shodanx/Micron-GLIN-v.2/docs/Рассчет тепловыделения.xlsx

Sheet: Лист1
Micron-GLIN | IC/Power bus power consumption (mA) | Vectron C4550A1-0213 | XC9572XL | LM399AH | 6xOPA189 | DAC11001A | WEG010016A | 2xLTC2057HV | LM3x7 | AD9832 | LTC6752HS5 | 2xSN74LV1T34 | ADUM4160 | STM32L152CBU6 | Total per line (mA) | Effective IC consumption (W) | Unreg. voltage (VDC) CoilV3 | Storage cap (uF) | Storage cap ripple (V) | LDO powerline noise (uV) | LDO voltage drop (V) | Dissipation on LDO (W)
 | 3.3V |  | 50.0 |  |  | 0.1 |  |  |  | 15 | 4.5 | 3 | 6 | 11.2 | 269.8 | 1.35 | 9.9 | 6800 | 0.79 | 79.35 | 4.54 | 1.331
 | +5V | 148 |  |  |  | 2 | 30
 | -15V |  |  | 36 | 7.8 | 12 |  |  | 11.4 |  |  |  |  |  | 67.2 | 1.01 | 26.3 | 2200 | 0.61 | 61.09 | 11.01 | 0.761
 | +15V |  |  | 37.3 | 7.8 | 12 |  |  | 11.4 |  |  |  |  |  | 68.5 | 1.03 | 26.3 | 2200 | 0.62 | 62.27 | 11.01 | 0.775
 | +30V |  |  |  |  |  |  | 1.8 | 4.2 |  |  |  |  |  | 5.96 | 0.18 | 42.5 | 470 | 0.25 | 25.36 | 12.35 | 0.074
 | -30V |  |  |  |  |  |  | 1.8 | 4.2 |  |  |  |  |  | 5.96 | 0.18 | 42.5 | 470 | 0.25 | 25.36 | 12.35 | 0.074
 | Effective IC consumption: |  |  |  |  | 3.742 | W
 | Dissipation on LDO: |  |  |  |  | 3.016 | W
 | Transformer Iq: |  |  |  |  | 3 | mA
 | Quiescent transformer dissipation: |  |  |  |  | 0.690 | W
 | Total: |  |  |  |  | 7.448 | W

Sheet: Рассчет трансформатора
ОСМ Т 230/Э/60-30/40-20/7-0.025-50 | Напряжение обмотки | Ток обмотки | Мощьность VA | Напряжение после выпрямления | Напряжение под типовой нагрузкой | Напряжение рассчетное при 253В
 | 30 | 0.05 | 1.5 | 41.1 | 42.48 | 46.728
 | -30 | 0.05 | 1.5 | -41.1 | -42.48 | -46.728
 | 20 | 0.25 | 5 | 27 | 26.32 | 28.952
 | -20 | 0.25 | 5 | -27 | -26.32 | -28.952
 | 7 | 1.7 | 11.9 | 9.27 | 9.933 | 10.9263
 |  |  | 24.9
ОСМ Т 230/Э/50-25/30-15/5-0.025-50 | Напряжение обмотки | Ток обмотки | Мощьность VA | Напряжение после выпрямления | Напряжение под типовой нагрузкой | Коэфицент
 | 25 | 0.1 | 2.5 | 34.05 | 35.4 | 1.416
 | -25 | 0.1 | 2.5 | -34.05 | -35.4 | 1.416
 | 15 | 0.25 | 3.75 | 19.95 | 19.74 | 1.316
 | -15 | 0.25 | 3.75 | -19.95 | -19.74 | 1.316
 | 5 | 2.5 | 12.5 | 6.45 | 7.095 | 1.419
 |  |  | 25

Sheet: ldo resistors
Vo | 15.00636364 | V | Vo | -15.04236364 | V
Iadj | 5e-05 | A | Iadj | 6.5e-05 | A
Vref | 1.25 | V | Vref | 1.25 | V
R1 | 220 | R | R1 | 220 | R | 0.007 | W
R2 | 2400 | R | R2 | 2400 | R | 0.079 | W
Vo | 29.92333333 | V | Vo | -30.02533333 | V
Iadj | 5e-05 | A | Iadj | 6.5e-05 | A
Vref | 1.25 | V | Vref | 1.25 | V
R1 | 300 | R | R1 | 300 | R | 0.005 | W
R2 | 6800 | R | R2 | 6800 | R | 0.122 | W
Vo | 7.555 | V | Vo | -7.5715 | V
Iadj | 5e-05 | A | Iadj | 6.5e-05 | A
Vref | 1.25 | V | Vref | 1.25 | V
R1 | 220 | R | R1 | 220 | R | 0.007 | W
R2 | 1100 | R | R2 | 1100 | R | 0.036 | W
