shodanx/Micron-GLIN-v.2/Timebase_CPLD_software/Timebase_CPLD/sch_pad.csv

Release 8.1i - Fit P.20131013
Copyright(c) 1995-2003 Xilinx Inc. All rights reserved
6-12-2022 9:06AM
NOTE: This file is designed to be imported into a spreadsheet program
such as Microsoft Excel for viewing | printing and sorting. The comma ' | '
character is used as the data field separator.
This file is also designed to support parsing.
Input file: sch.ngd
output file: sch_pad.csv
Part type: xc9572xl
Speed grade: -10
Package: vq44
Pinout by Pin Number:
----- | ----- | ----- | ----- | ----- | ----- | ----- | ----- | ----- | -----
Pin Number | Signal Name | Pin Usage | Pin Name | Direction | IO Standard | IO Bank Number | {blank} | Slew Rate | Termination | {blank} | Voltage | Constraint
P1 | DDS_FREQ | GCK | I/O/GCK3
P2 | TIE |  | I/O
P3 | TIE |  | I/O
P4 | GND |  | GND
P5 | TIE |  | I/O
P6 | TIE |  | I/O
P7 | TIE |  | I/O
P8 | TIE |  | I/O
P9 | TDI |  | TDI
P10 | TMS |  | TMS
P11 | TCK |  | TCK
P12 | TIE |  | I/O
P13 | TIE |  | I/O
P14 | TIE |  | I/O
P15 | VCC |  | VCCINT
P16 | TIE |  | I/O
P17 | GND |  | GND
P18 | TIE |  | I/O
P19 | Freq_control<3> | I | I/O | INPUT
P20 | Freq_control<2> | I | I/O | INPUT
P21 | Freq_control<1> | I | I/O | INPUT
P22 | Freq_control<0> | I | I/O | INPUT
P23 | CPU_IRQ | O | I/O | OUTPUT
P24 | TDO |  | TDO
P25 | GND |  | GND
P26 | VCC |  | VCCIO
P27 | DAC_LDAC | O | I/O | OUTPUT
P28 | COUNT_EN | I | I/O | INPUT
P29 | TIE |  | I/O
P30 | TIE |  | I/O
P31 | TIE |  | I/O
P32 | TIE |  | I/O
P33 | TIE |  | I/O/GSR
P34 | TIE |  | I/O/GTS2
P35 | VCC |  | VCCINT
P36 | TIE |  | I/O/GTS1
P37 | TIE |  | I/O
P38 | TIE |  | I/O
P39 | TIE |  | I/O
P40 | TIE |  | I/O
P41 | TIE |  | I/O
P42 | TIE |  | I/O
P43 | IN_10MHz | GCK | I/O/GCK1
P44 | TIE |  | I/O/GCK2
To preserve the pinout above for future design iterations in
Project Navigator simply execute the (Lock Pins) process
located under the (Implement Design) process in a toolbox named
(Optional Implementation Tools) or invoke PIN2UCF from the
command line. The location constraints will be written into your
specified UCF file
