shodanx/Micron-GLIN-v.2/Active_GLONASS_GPS_antenna/Case/Сборка1.SLDASM

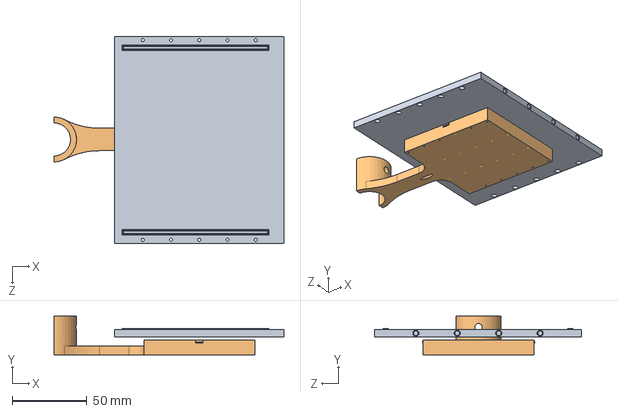
[picture p1: CAD file, 2022-07-23]
Active_GLONASS_GPS_antenna/Case/Сборка1.SLDASM
153.4 x 26.0 x 138.1 mm
buttom_part
top
