shodanx/Micron-GLIN-v.2/GLIN Case/Сборка1.SLDASM

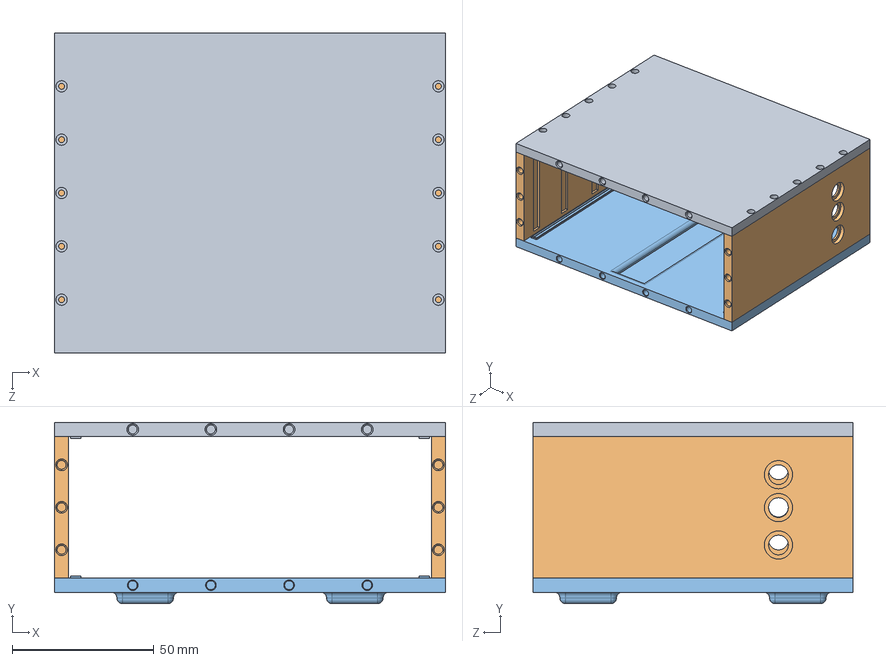
[picture p2: CAD file, 2022-07-24]
GLIN Case/Сборка1.SLDASM
138.1 x 64.0 x 113.0 mm
top
right x 2
bot
