shodanx/Micron-GLIN-v.2/SLS_parts/ADR1399_CAP/set.SLDASM

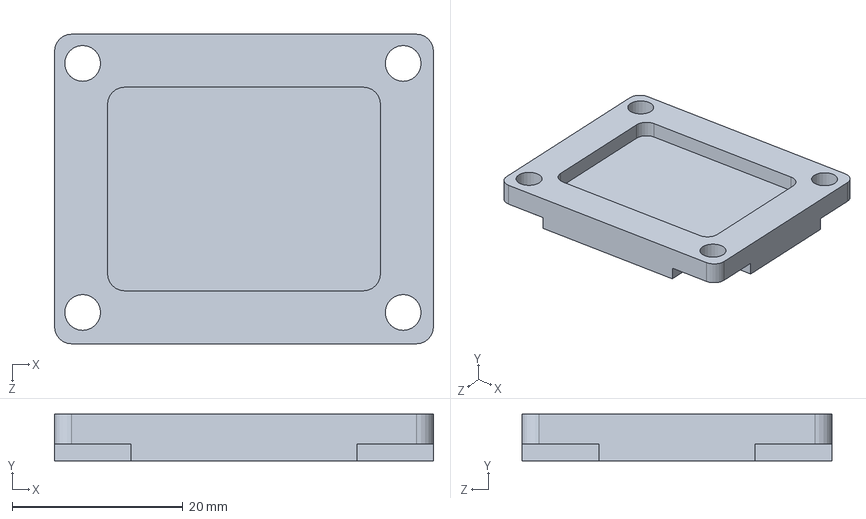
[picture p3: CAD file, 2022-04-26]
SLS_parts/ADR1399_CAP/set.SLDASM
44.5 x 5.50 x 36.3 mm
