shodanx/Micron-GLIN-v.2/SLS_parts/DAC_CAP/set.SLDASM

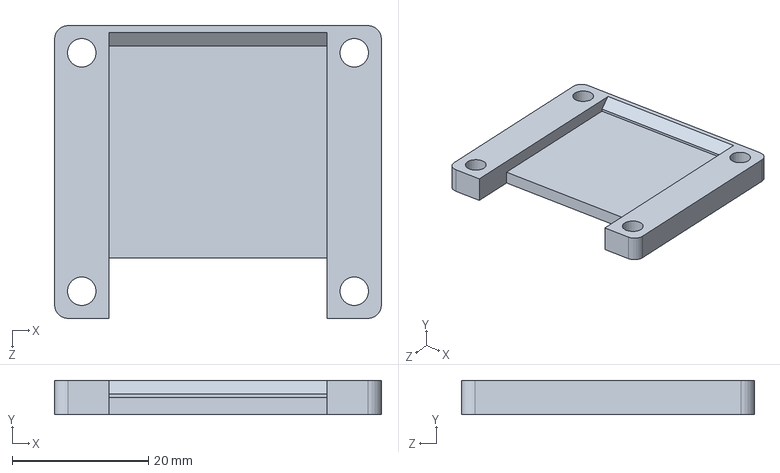
[picture p4: CAD file, 2022-04-26]
SLS_parts/DAC_CAP/set.SLDASM
48.0 x 5.00 x 43.0 mm
