shodanx/Micron-GLIN-v.2/SLS_parts/OCXO_CAP/set.SLDASM

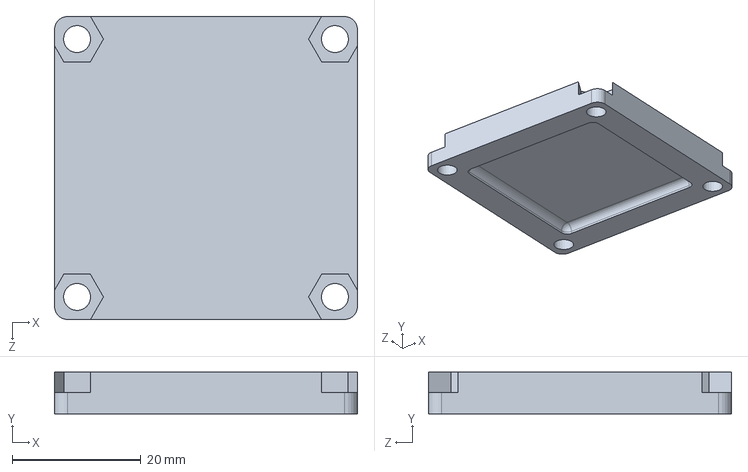
[picture p5: CAD file, 2022-04-26]
SLS_parts/OCXO_CAP/set.SLDASM
47.0 x 6.50 x 47.0 mm
