shodanx/Micron-GLIN-v.2/Active_GLONASS_GPS_antenna/Case/buttom_part.SLDPRT

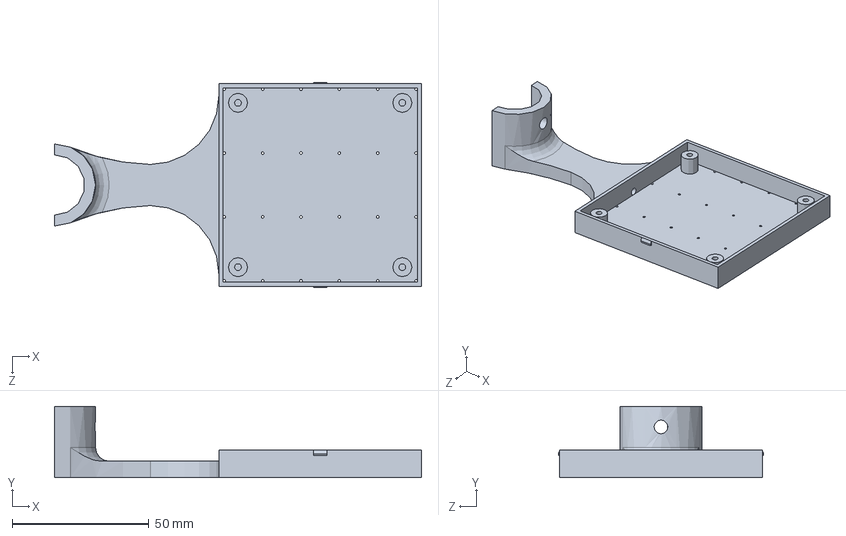
[picture p6: CAD file, 2022-07-24]
Active_GLONASS_GPS_antenna/Case/buttom_part.SLDPRT
134.0 x 26.0 x 75.0 mm
