shodanx/Micron-GLIN-v.2/GLIN Case/top.SLDPRT

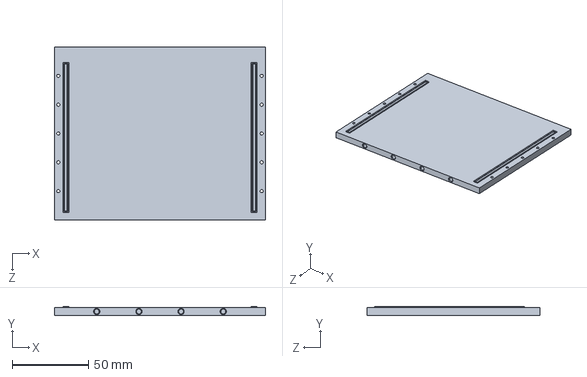
[picture p7: CAD file, 2022-07-24]
GLIN Case/top.SLDPRT
138.1 x 5.70 x 113.0 mm
