shodanx/Micron-GLIN-v.2/SLS_parts/ADR1399_CAP/ADR1399_soldering_tool.STEP

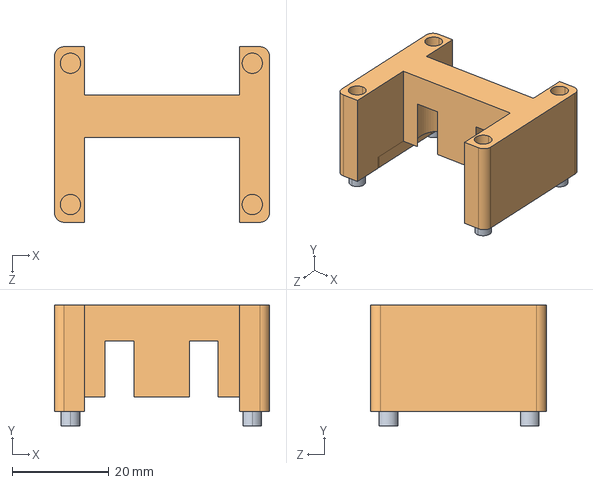
[picture p8: CAD file, 2022-04-26]
SLS_parts/ADR1399_CAP/ADR1399_soldering_tool.STEP
44.5 x 25.0 x 36.3 mm
