shodanx/Micron-GLIN-v.2/SLS_parts/LM399_CAP/LM399AH_UP.STEP

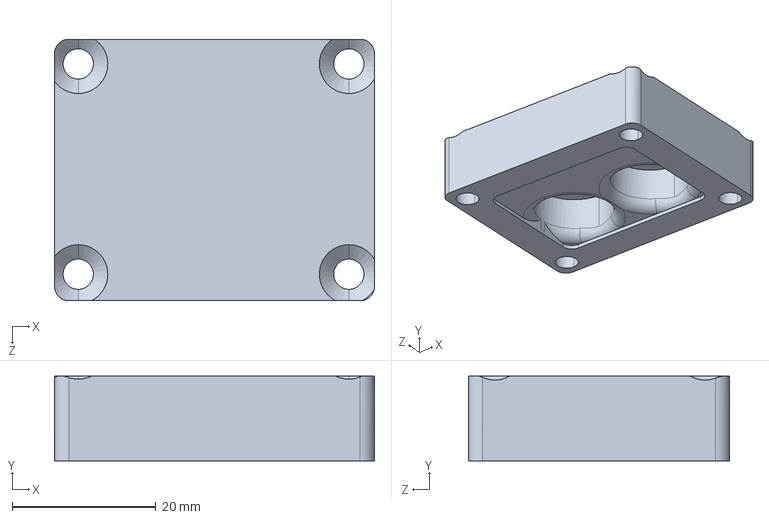
[picture p9: CAD file, 2022-04-26]
SLS_parts/LM399_CAP/LM399AH_UP.STEP
44.5 x 11.8 x 36.3 mm
