shodanx/Micron-GLIN-v.2/SLS_parts/OCXO_CAP/OCXO_up.STEP

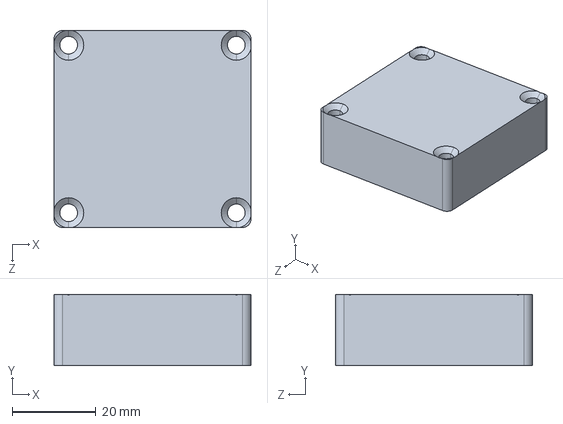
[picture p10: CAD file, 2022-04-26]
SLS_parts/OCXO_CAP/OCXO_up.STEP
47.0 x 17.0 x 47.0 mm
