shodanx/Micron-GLIN-v.2/Active_GLONASS_GPS_antenna/Case/top.SLDPRT

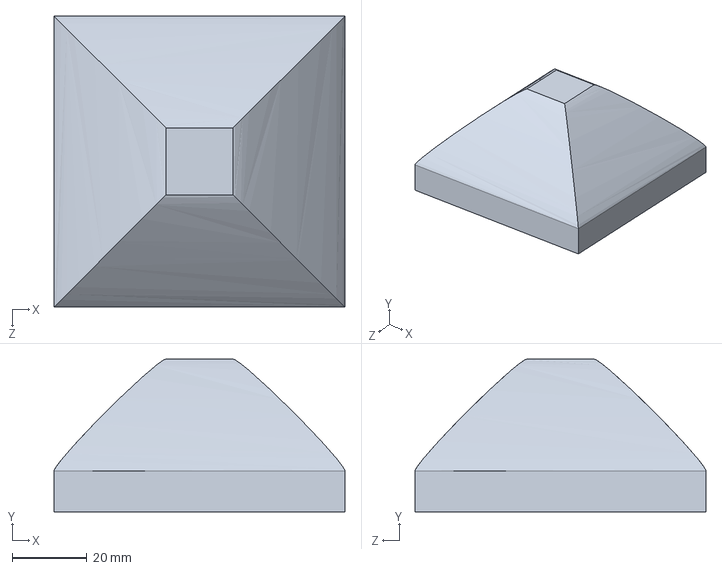
[picture p11: CAD file, 2022-07-23]
Active_GLONASS_GPS_antenna/Case/top.SLDPRT
78.0 x 41.0 x 78.0 mm
