shodanx/Micron-GLIN-v.2/GLIN Case/bot.SLDPRT

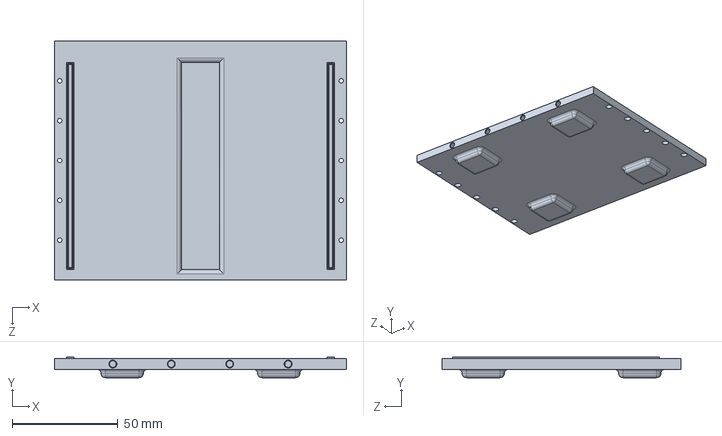
[picture p12: CAD file, 2022-07-24]
GLIN Case/bot.SLDPRT
138.1 x 9.70 x 113.0 mm
