shodanx/Micron-GLIN-v.2/GLIN Case/right.SLDPRT

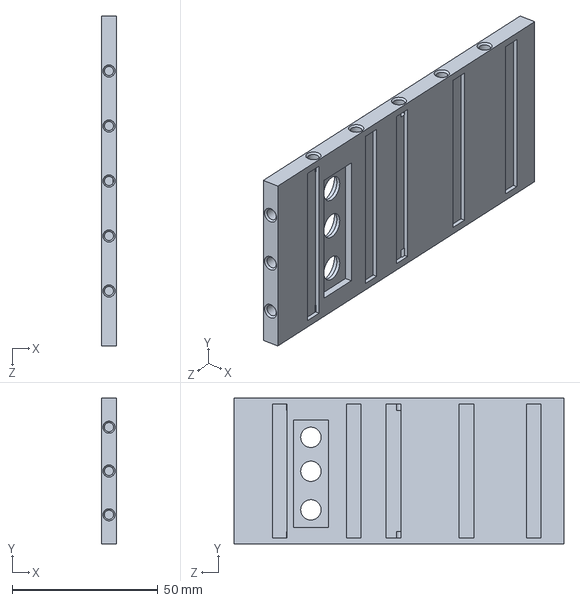
[picture p13: CAD file, 2022-07-24]
GLIN Case/right.SLDPRT
5.00 x 50.0 x 113.0 mm
