shodanx/Micron-GLIN-v.2/SLS_parts/ADR1399_CAP/ADR1399_UP.STEP

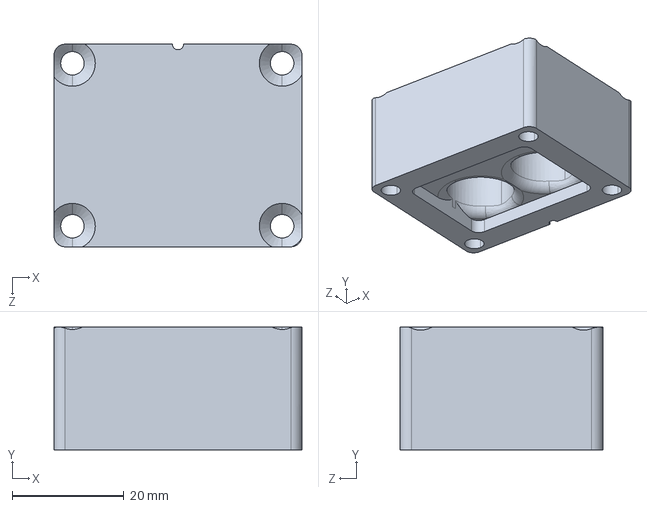
[picture p14: CAD file, 2022-04-26]
SLS_parts/ADR1399_CAP/ADR1399_UP.STEP
44.5 x 22.0 x 36.3 mm
