shodanx/Micron-GLIN-v.2/(list of files, cad)

Other CAD files:
Timebase_CPLD_software/Timebase_CPLD/isim/sch_isim_beh.exe.sim/work/sch_isim_beh.exe_main.nt64.obj
SLS_parts/DAC_CAP/DAC_down.STEP
Timebase_CPLD_software/Timebase_CPLD/isim/precompiled.exe.sim/ieee/p_1242562249.nt64.obj
Timebase_CPLD_software/Timebase_CPLD/isim/sch_isim_beh.exe.sim/unisim/a_4147737283_2967259552.nt64.obj
Timebase_CPLD_software/Timebase_CPLD/isim/sch_isim_beh.exe.sim/work/a_3463945714_3212880686.nt64.obj
SLS_parts/ADR1399_CAP/ADR1399_DOWN.STEP
SLS_parts/DAC_CAP/DAC_up.STEP
SLS_parts/OCXO_CAP/OCXO_down.STEP
Timebase_CPLD_software/Timebase_CPLD/isim/precompiled.exe.sim/ieee/p_2592010699.nt64.obj
Timebase_CPLD_software/Timebase_CPLD/isim/sch_isim_beh.exe.sim/unisim/a_2867636556_1359619727.nt64.obj
Timebase_CPLD_software/Timebase_CPLD/isim/sch_isim_beh.exe.sim/unisim/a_4207005572_0559031411.nt64.obj
Timebase_CPLD_software/Timebase_CPLD/isim/sch_isim_beh.exe.sim/work/a_2451983098_3212880686.nt64.obj
Timebase_CPLD_software/Timebase_CPLD/isim/sch_isim_beh.exe.sim/unisim/a_2211953871_3811244703.nt64.obj
Timebase_CPLD_software/Timebase_CPLD/isim/sch_isim_beh.exe.sim/work/a_2857804981_3212880686.nt64.obj
Timebase_CPLD_software/Timebase_CPLD/isim/sch_isim_beh.exe.sim/unisim/a_3056901965_2640411640.nt64.obj
Timebase_CPLD_software/Timebase_CPLD/isim/sch_isim_beh.exe.sim/work/a_2267817849_3212880686.nt64.obj
Timebase_CPLD_software/Timebase_CPLD/isim/sch_isim_beh.exe.sim/unisim/a_3055263662_1392679692.nt64.obj
Timebase_CPLD_software/Timebase_CPLD/isim/sch_isim_beh.exe.sim/work/a_3195776209_3212880686.nt64.obj
Timebase_CPLD_software/Timebase_CPLD/isim/sch_isim_beh.exe.sim/unisim/a_3828308815_1222000726.nt64.obj
Timebase_CPLD_software/Timebase_CPLD/isim/sch_isim_beh.exe.sim/work/a_3409553495_3212880686.nt64.obj
Timebase_CPLD_software/Timebase_CPLD/isim/sch_isim_beh.exe.sim/unisim/a_1801614988_1818890047.nt64.obj
Timebase_CPLD_software/Timebase_CPLD/isim/sch_isim_beh.exe.sim/work/a_0098054934_3212880686.nt64.obj
Timebase_CPLD_software/Timebase_CPLD/isim/sch_isim_beh.exe.sim/unisim/a_2077515722_3691801974.nt64.obj
Timebase_CPLD_software/Timebase_CPLD/isim/sch_isim_beh.exe.sim/work/a_0897150575_3212880686.nt64.obj
Timebase_CPLD_software/Timebase_CPLD/isim/sch_isim_beh.exe.sim/unisim/a_2211589156_2274105955.nt64.obj
Timebase_CPLD_software/Timebase_CPLD/isim/sch_isim_beh.exe.sim/work/a_1424174025_3212880686.nt64.obj
Timebase_CPLD_software/Timebase_CPLD/isim/sch_isim_beh.exe.sim/unisim/a_1391413833_1848422758.nt64.obj
Timebase_CPLD_software/Timebase_CPLD/isim/sch_isim_beh.exe.sim/work/a_4223124715_3212880686.nt64.obj
Timebase_CPLD_software/Timebase_CPLD/isim/sch_isim_beh.exe.sim/unisim/a_3762448000_2971575191.nt64.obj
Timebase_CPLD_software/Timebase_CPLD/isim/sch_isim_beh.exe.sim/work/a_2808649626_3212880686.nt64.obj
Timebase_CPLD_software/Timebase_CPLD/isim/sch_isim_beh.exe.sim/unisim/a_3988446151_0546328132.nt64.obj
Timebase_CPLD_software/Timebase_CPLD/isim/sch_isim_beh.exe.sim/work/a_0418817255_3212880686.nt64.obj
Timebase_CPLD_software/Timebase_CPLD/isim/sch_isim_beh.exe.sim/unisim/a_2233457742_0889792898.nt64.obj
Timebase_CPLD_software/Timebase_CPLD/isim/sch_isim_beh.exe.sim/work/a_1497938270_3212880686.nt64.obj
Timebase_CPLD_software/Timebase_CPLD/isim/sch_isim_beh.exe.sim/unisim/a_2562466605_1496654361.nt64.obj
Timebase_CPLD_software/Timebase_CPLD/isim/sch_isim_beh.exe.sim/unisim/p_0947159679.nt64.obj
Timebase_CPLD_software/Timebase_CPLD/isim/sch_isim_beh.exe.sim/unisim/a_2661327437_0605893366.nt64.obj
Timebase_CPLD_software/Timebase_CPLD/isim/sch_isim_beh.exe.sim/unisim/a_1823427465_3721267009.nt64.obj
Timebase_CPLD_software/Timebase_CPLD/isim/sch_isim_beh.exe.sim/unisim/a_1947232985_2580864354.nt64.obj
Timebase_CPLD_software/Timebase_CPLD/isim/sch_isim_beh.exe.sim/unisim/a_1113154319_3729445679.nt64.obj
Timebase_CPLD_software/Timebase_CPLD/isim/sch_isim_beh.exe.sim/unisim/a_1490675510_1976025627.nt64.obj
Timebase_CPLD_software/Timebase_CPLD/isim/sch_isim_beh.exe.sim/unisim/a_1717296735_4086321779.nt64.obj
Timebase_CPLD_software/Timebase_CPLD/isim/sch_isim_beh.exe.sim/unisim/a_0147727936_3632337348.nt64.obj
Timebase_CPLD_software/Timebase_CPLD/isim/sch_isim_beh.exe.sim/unisim/a_2472646025_1397528790.nt64.obj
Timebase_CPLD_software/Timebase_CPLD/isim/sch_isim_beh.exe.sim/unisim/a_2312877582_0635394241.nt64.obj
Timebase_CPLD_software/Timebase_CPLD/isim/sch_isim_beh.exe.sim/unisim/a_2904659017_3769511665.nt64.obj
SLS_parts/ADR1399_CAP/ADR1399_DOWN.SLDPRT
SLS_parts/ADR1399_CAP/ADR1399_UP.SLDPRT
SLS_parts/ADR1399_CAP/ADR1399_soldering_tool.SLDPRT
SLS_parts/DAC_CAP/DAC_down.SLDPRT
SLS_parts/DAC_CAP/DAC_up.SLDPRT
SLS_parts/LM399_CAP/LM399AH_UP.SLDPRT
SLS_parts/OCXO_CAP/OCXO_down.SLDPRT
SLS_parts/OCXO_CAP/OCXO_up.SLDPRT
