shodanx/Micron-GLIN-v.2/docs/INL_fix.xlsx

Sheet: Data
Poly_temp_A | -8.4559e-22 | Step 2 - calculate and place poly. coefficents
Poly_temp_B | 1.7961e-15
Poly_temp_C | -9.7371e-10
Poly_temp_D | 0.00013705
 | Step 1 - place data here
Time (s) | Reading (V) | DAC Code | diff 2 step (mV/s) | diff 10 step(mV/s) | Ideal | Error INL | Error calc | Error speed | Correction_coeff | St_dev | Avg | RSD
1 | -9.97158607 | 524.8128128 |  |  |  |  |  |  |  | 0.0002592288754 | 10.000009 | 2.592286368e-05 | 10.0005 | 1.00005 | 10.000000000
2 | -9.96158394 | 1049.625626 | 10.002130 |  | -9.961443 | 0.000141 | 0.000136
3 | -9.95157888 | 1574.438438 | 10.005060 |  | -9.951443 | 0.000136 | 0.000136 | -0.0000005 | 1.0000509 | Step |  | DAC code per step
4 | -9.94157767 | 2099.251251 | 10.001210 | 10.001221 | -9.941443 | 0.000135 | 0.000135 | -0.0000005 | 1.0000508 | 0.01 |  | 524.8128128
5 | -9.93157697 | 2624.064064 | 10.000700 | 10.000838 | -9.931443 | 0.000134 | 0.000135 | -0.0000005 | 1.0000507
6 | -9.92157523 | 3148.876877 | 10.001740 | 10.000759 | -9.921443 | 0.000132 | 0.000134 | -0.0000005 | 1.0000506
7 | -9.91157488 | 3673.68969 | 10.000350 | 10.000514 | -9.911443 | 0.000132 | 0.000133 | -0.0000005 | 1.0000505
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
