shodanx/Micron-GLIN-v.2/Project_Files/Schematic/Active_GNSS_antenna.PDF

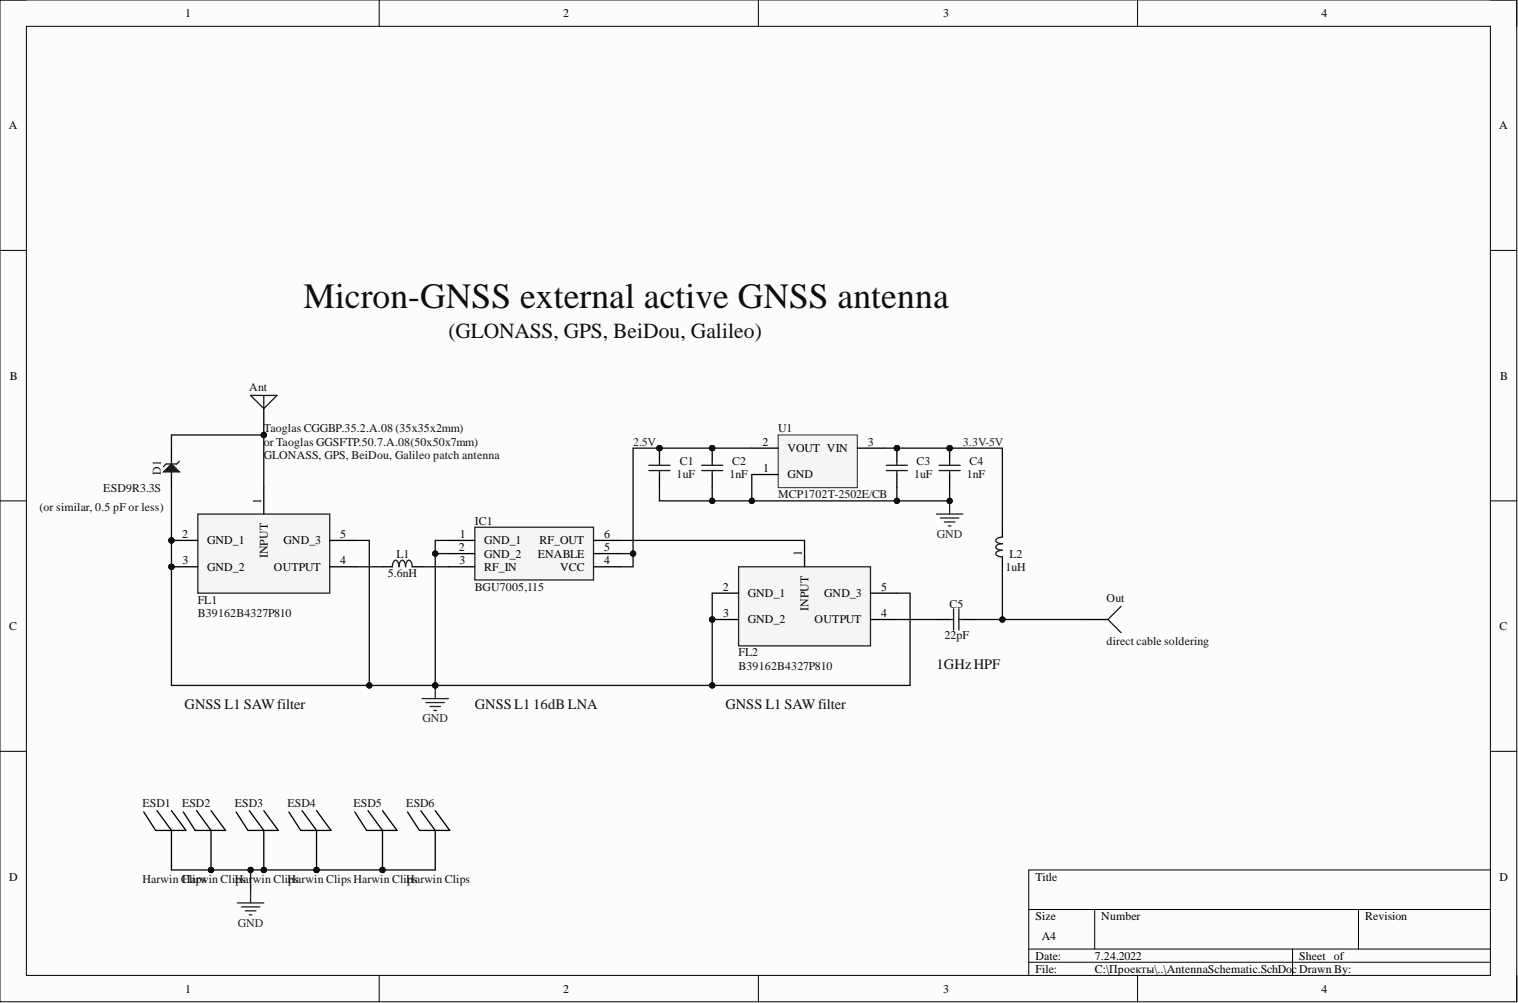
[picture p15: page 1]

Micron-GNSS external active GNSS antenna

(GLONASS, GPS, BeiDou, Galileo)

Taoglas CGGBP.35.2.A.08 (35x35x2mm)
or Taoglas GGSFTP.50.7.A.08(50x50x7mm)
GLONASS, GPS, BeiDou, Galileo patch antenna

(or similar, 0.5 pF or less)
