shodanx/Micron-GLIN-v.2/Project_Files/Schematic/Timebase board.PDF

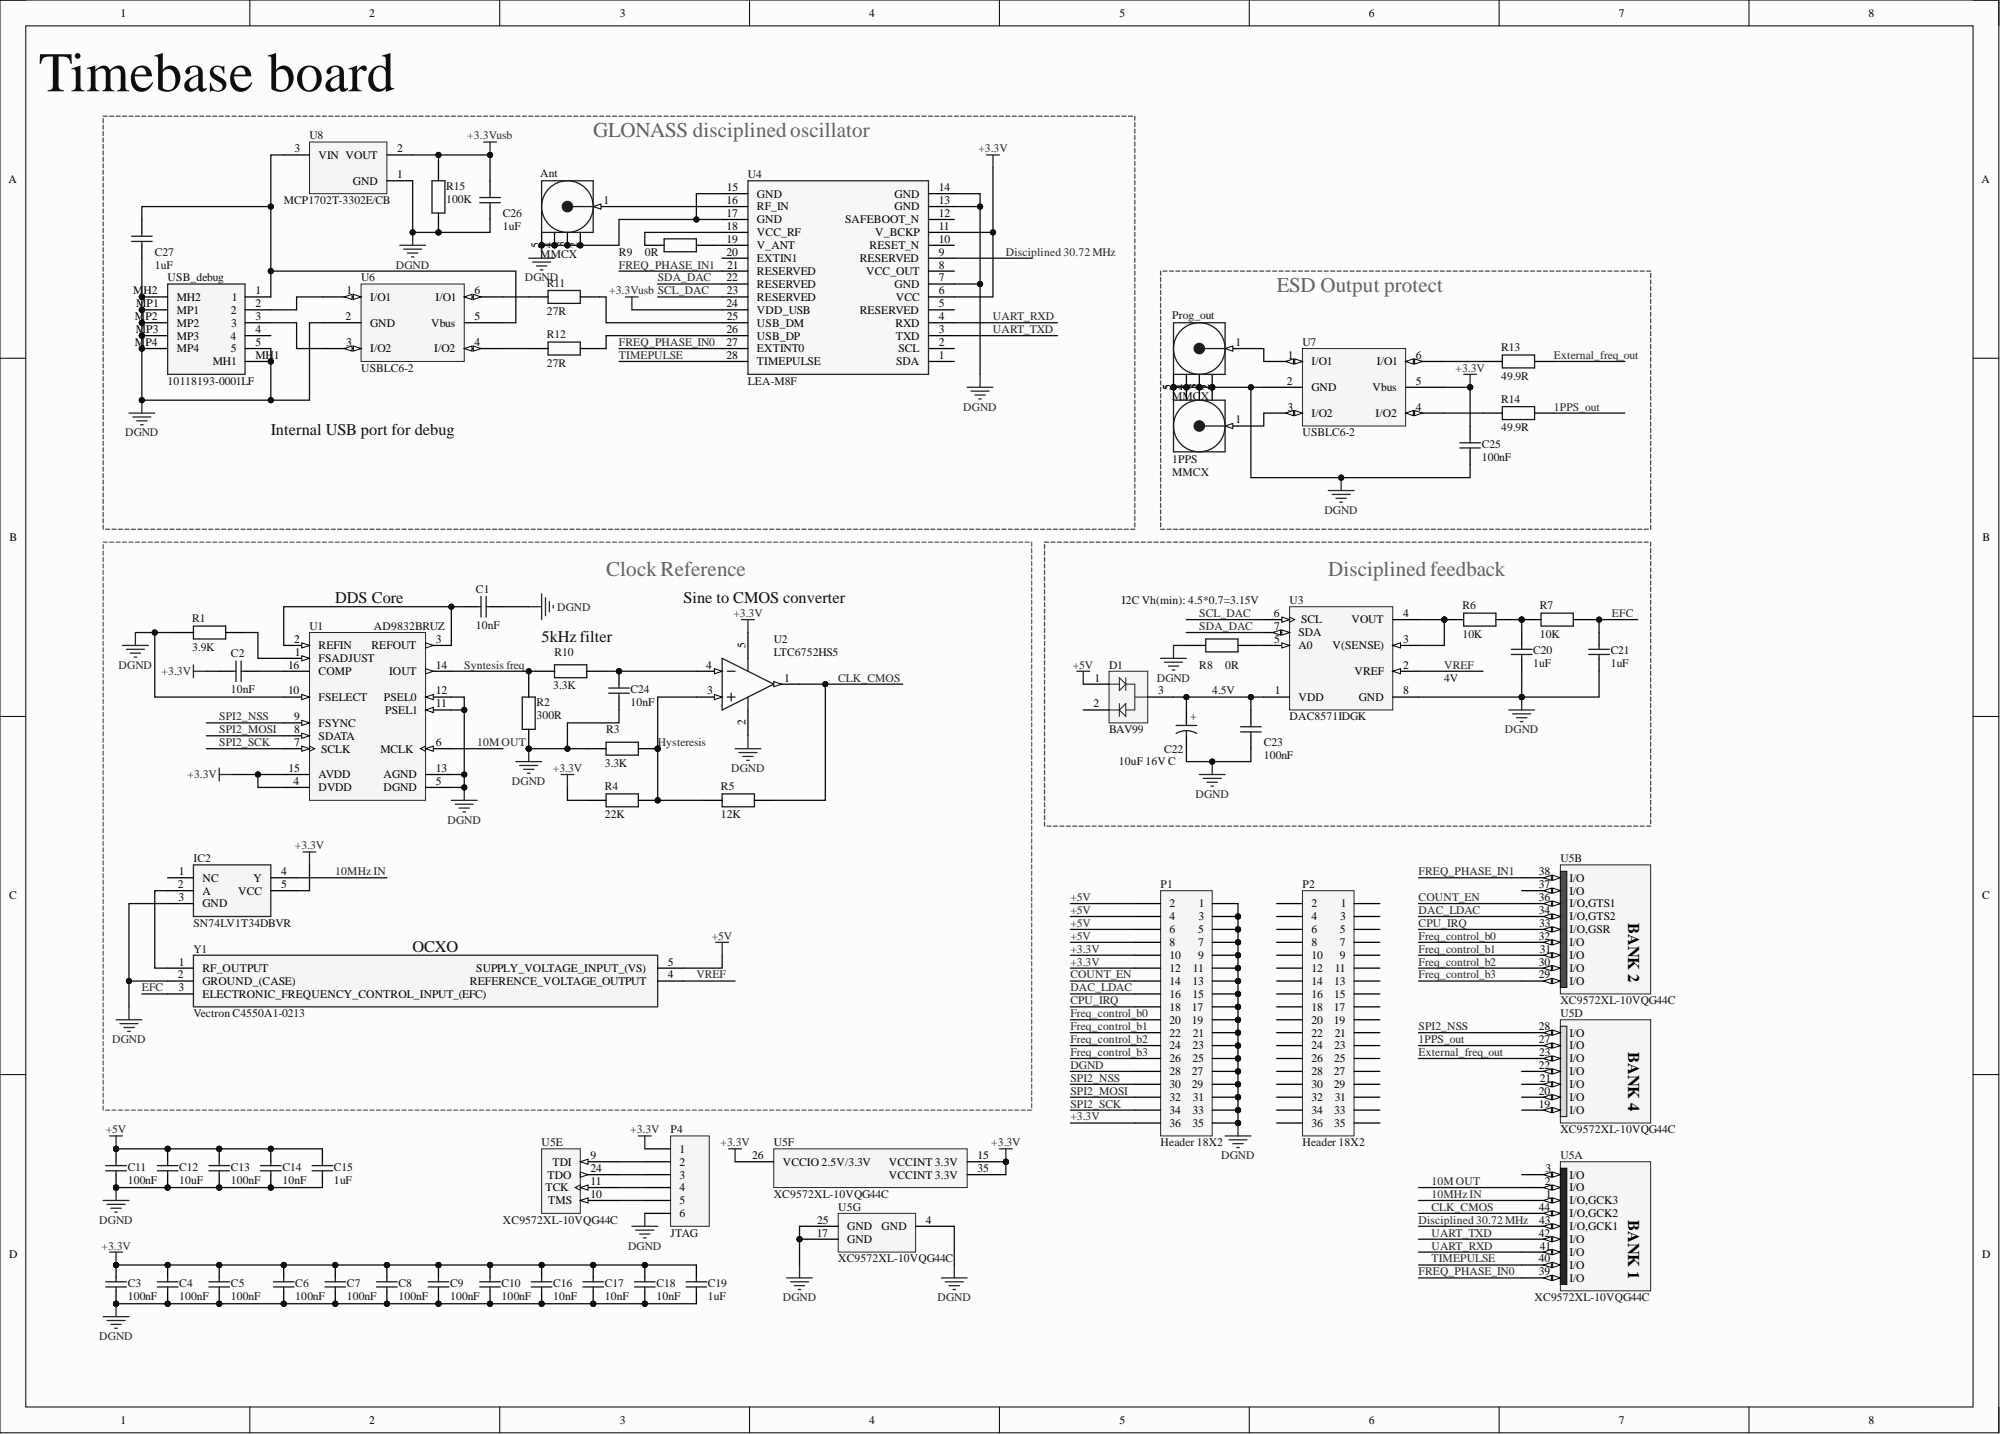
[picture p16: page 1]

RF_IN 16 GND 17

VCC_RF 18

Internal USB port for debug
