shodanx/Micron-GLIN-v.2/Project_Files/Schematic/DAC board.PDF

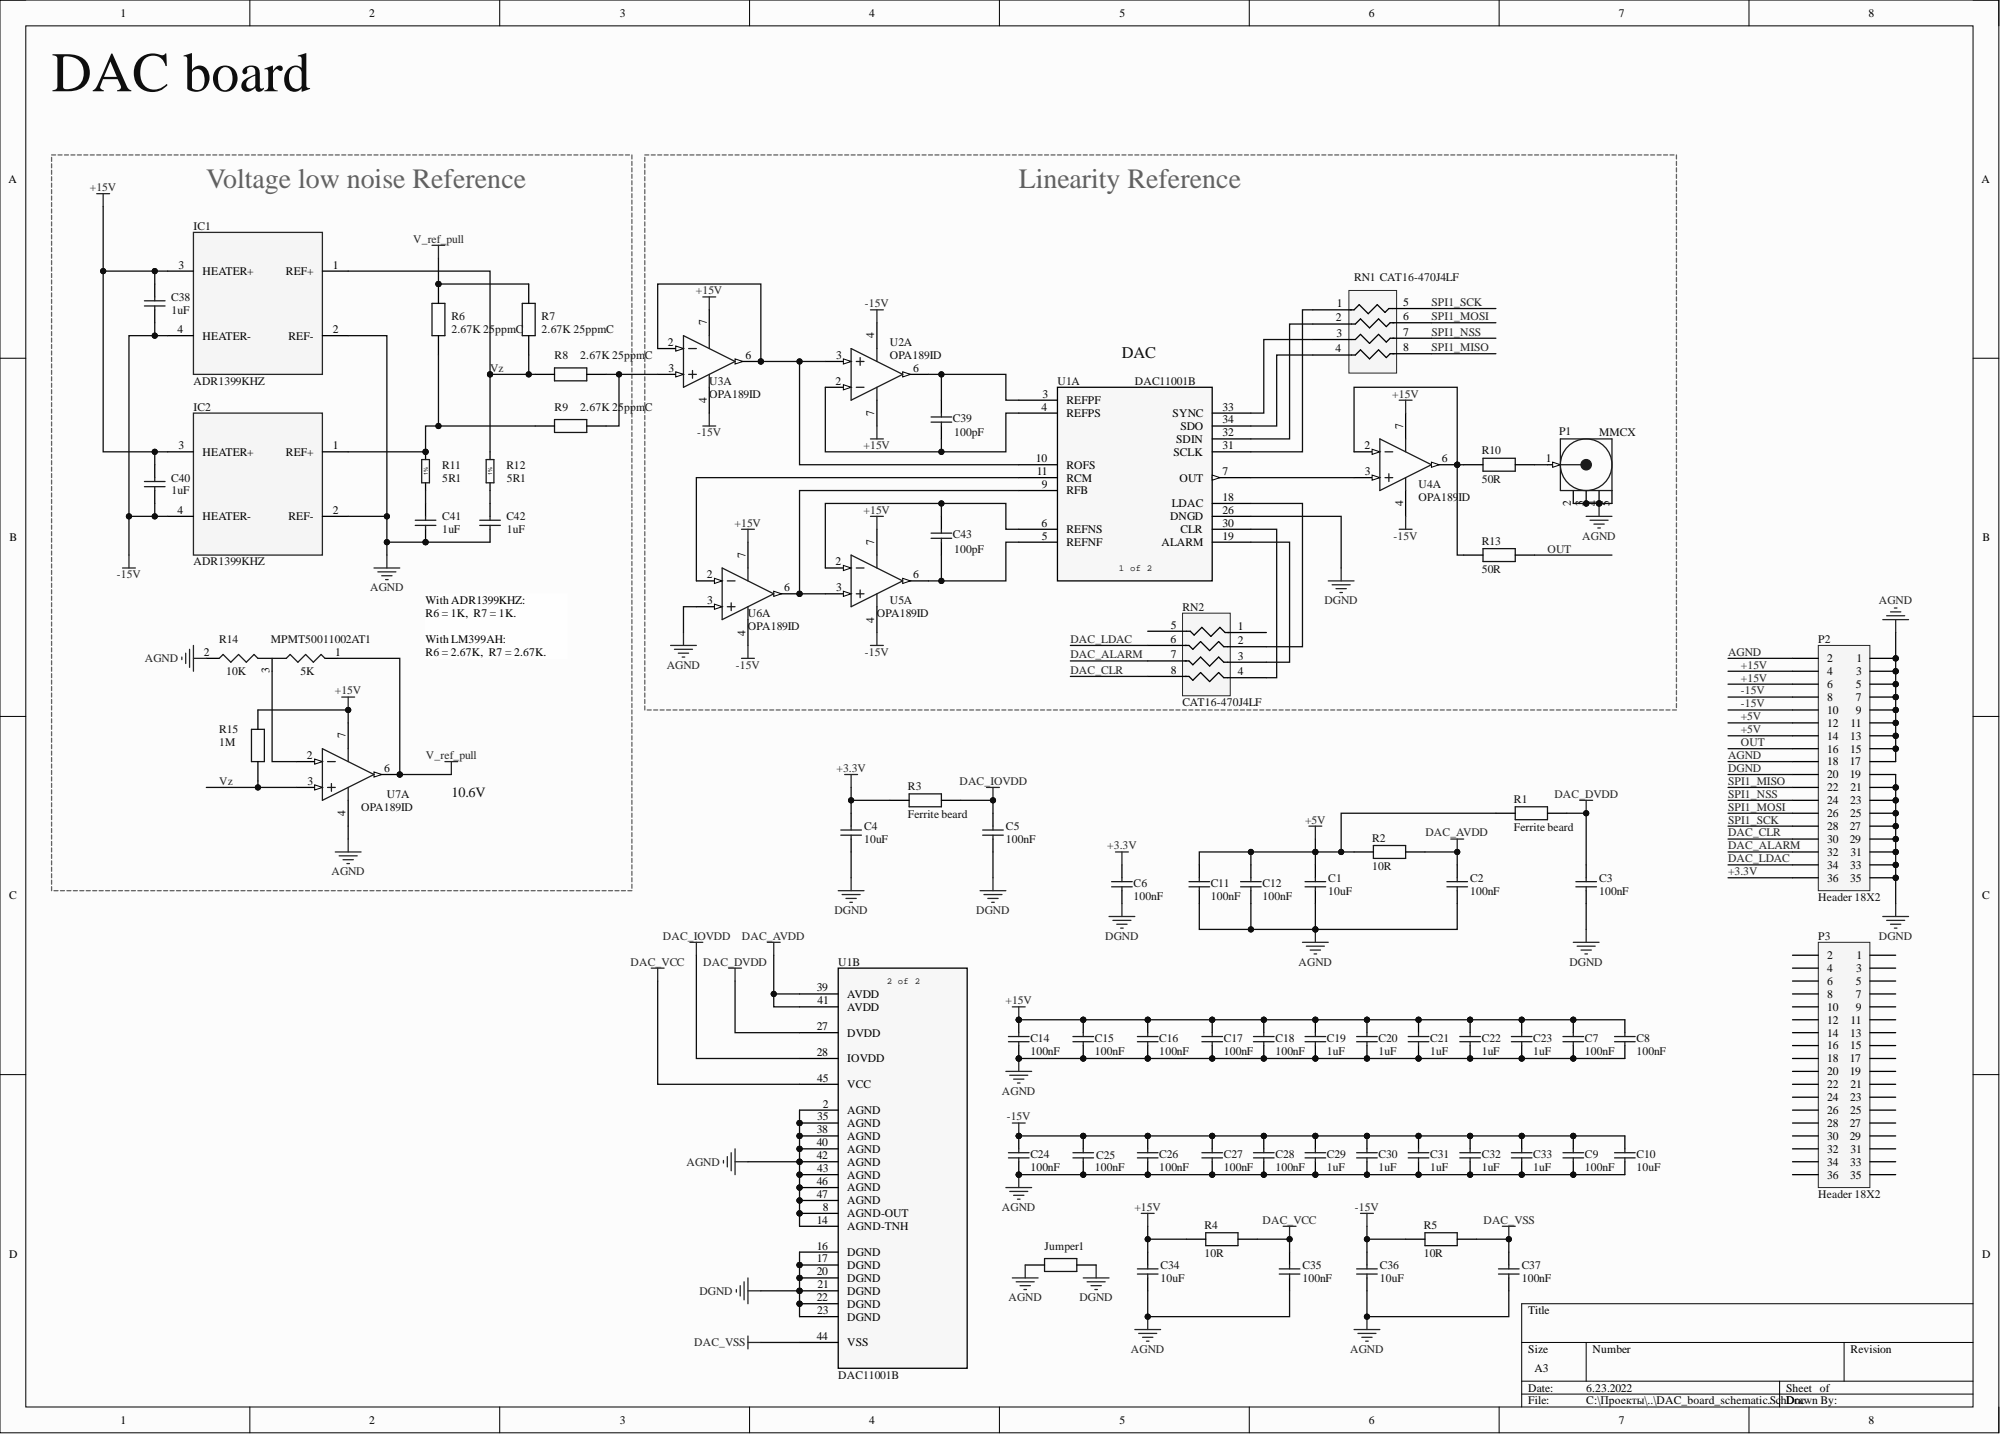
[picture p17: page 1]

Voltage low noise Reference

C38 1uF | HEATER- 4

REFPS 4

RCM 11 | 3
RFB 9

REFNF 5 REFNS 6

C43
100pF
