shodanx/Micron-GLIN-v.2/Project_Files/Schematic/Output board.PDF

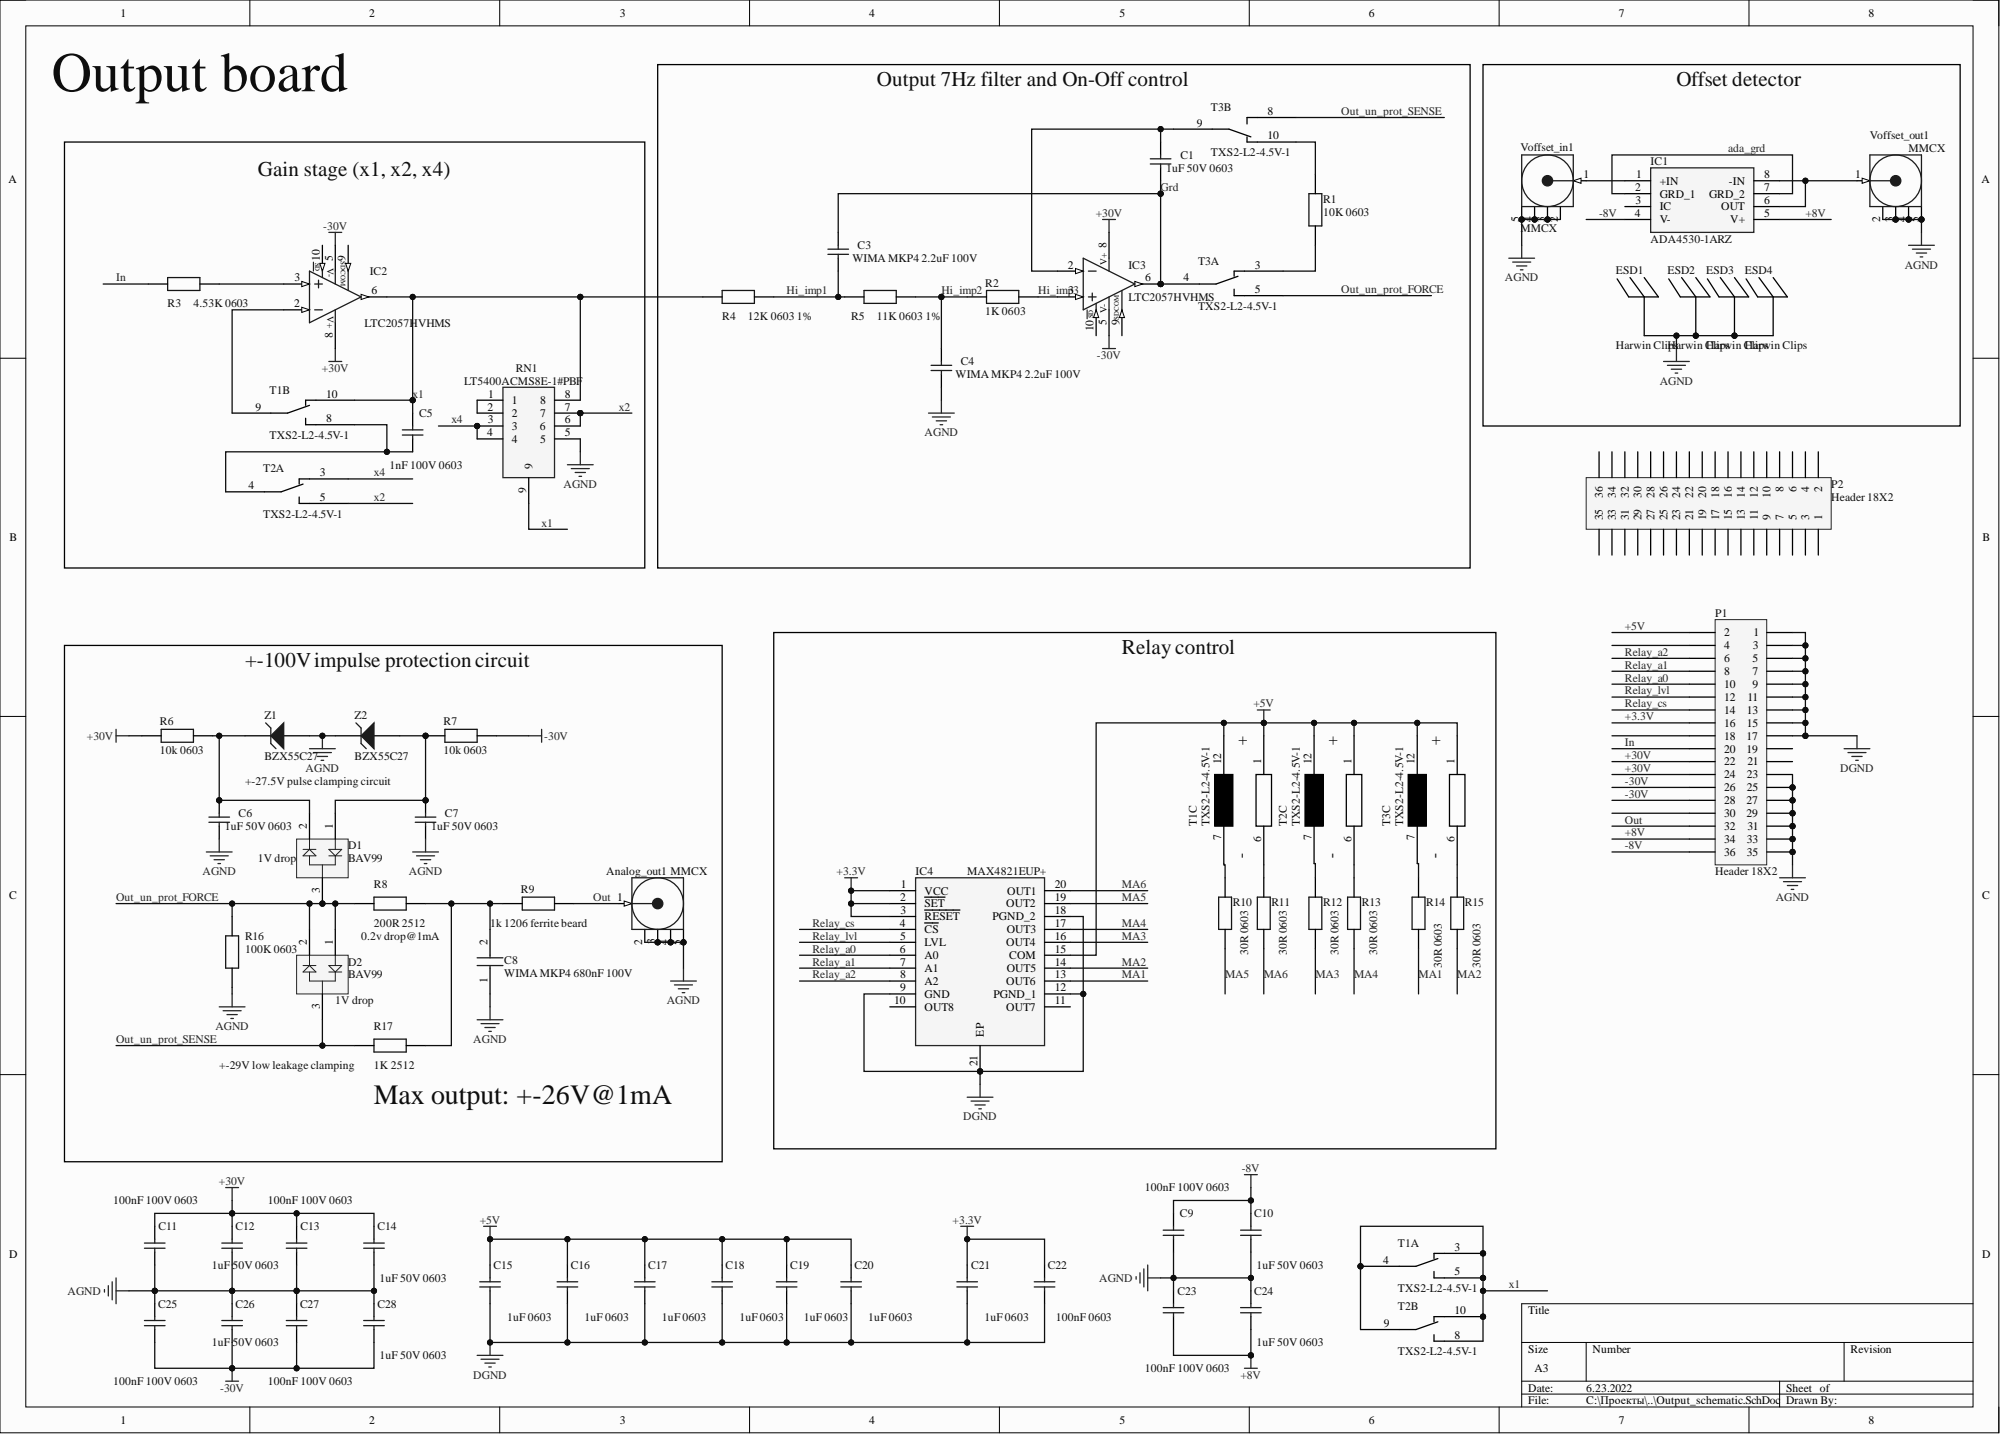
[picture p18: page 1]

Output 7Hz filter and On-Off control
