shodanx/Micron-GLIN-v.2/Project_Files/Schematic/Digital board.PDF

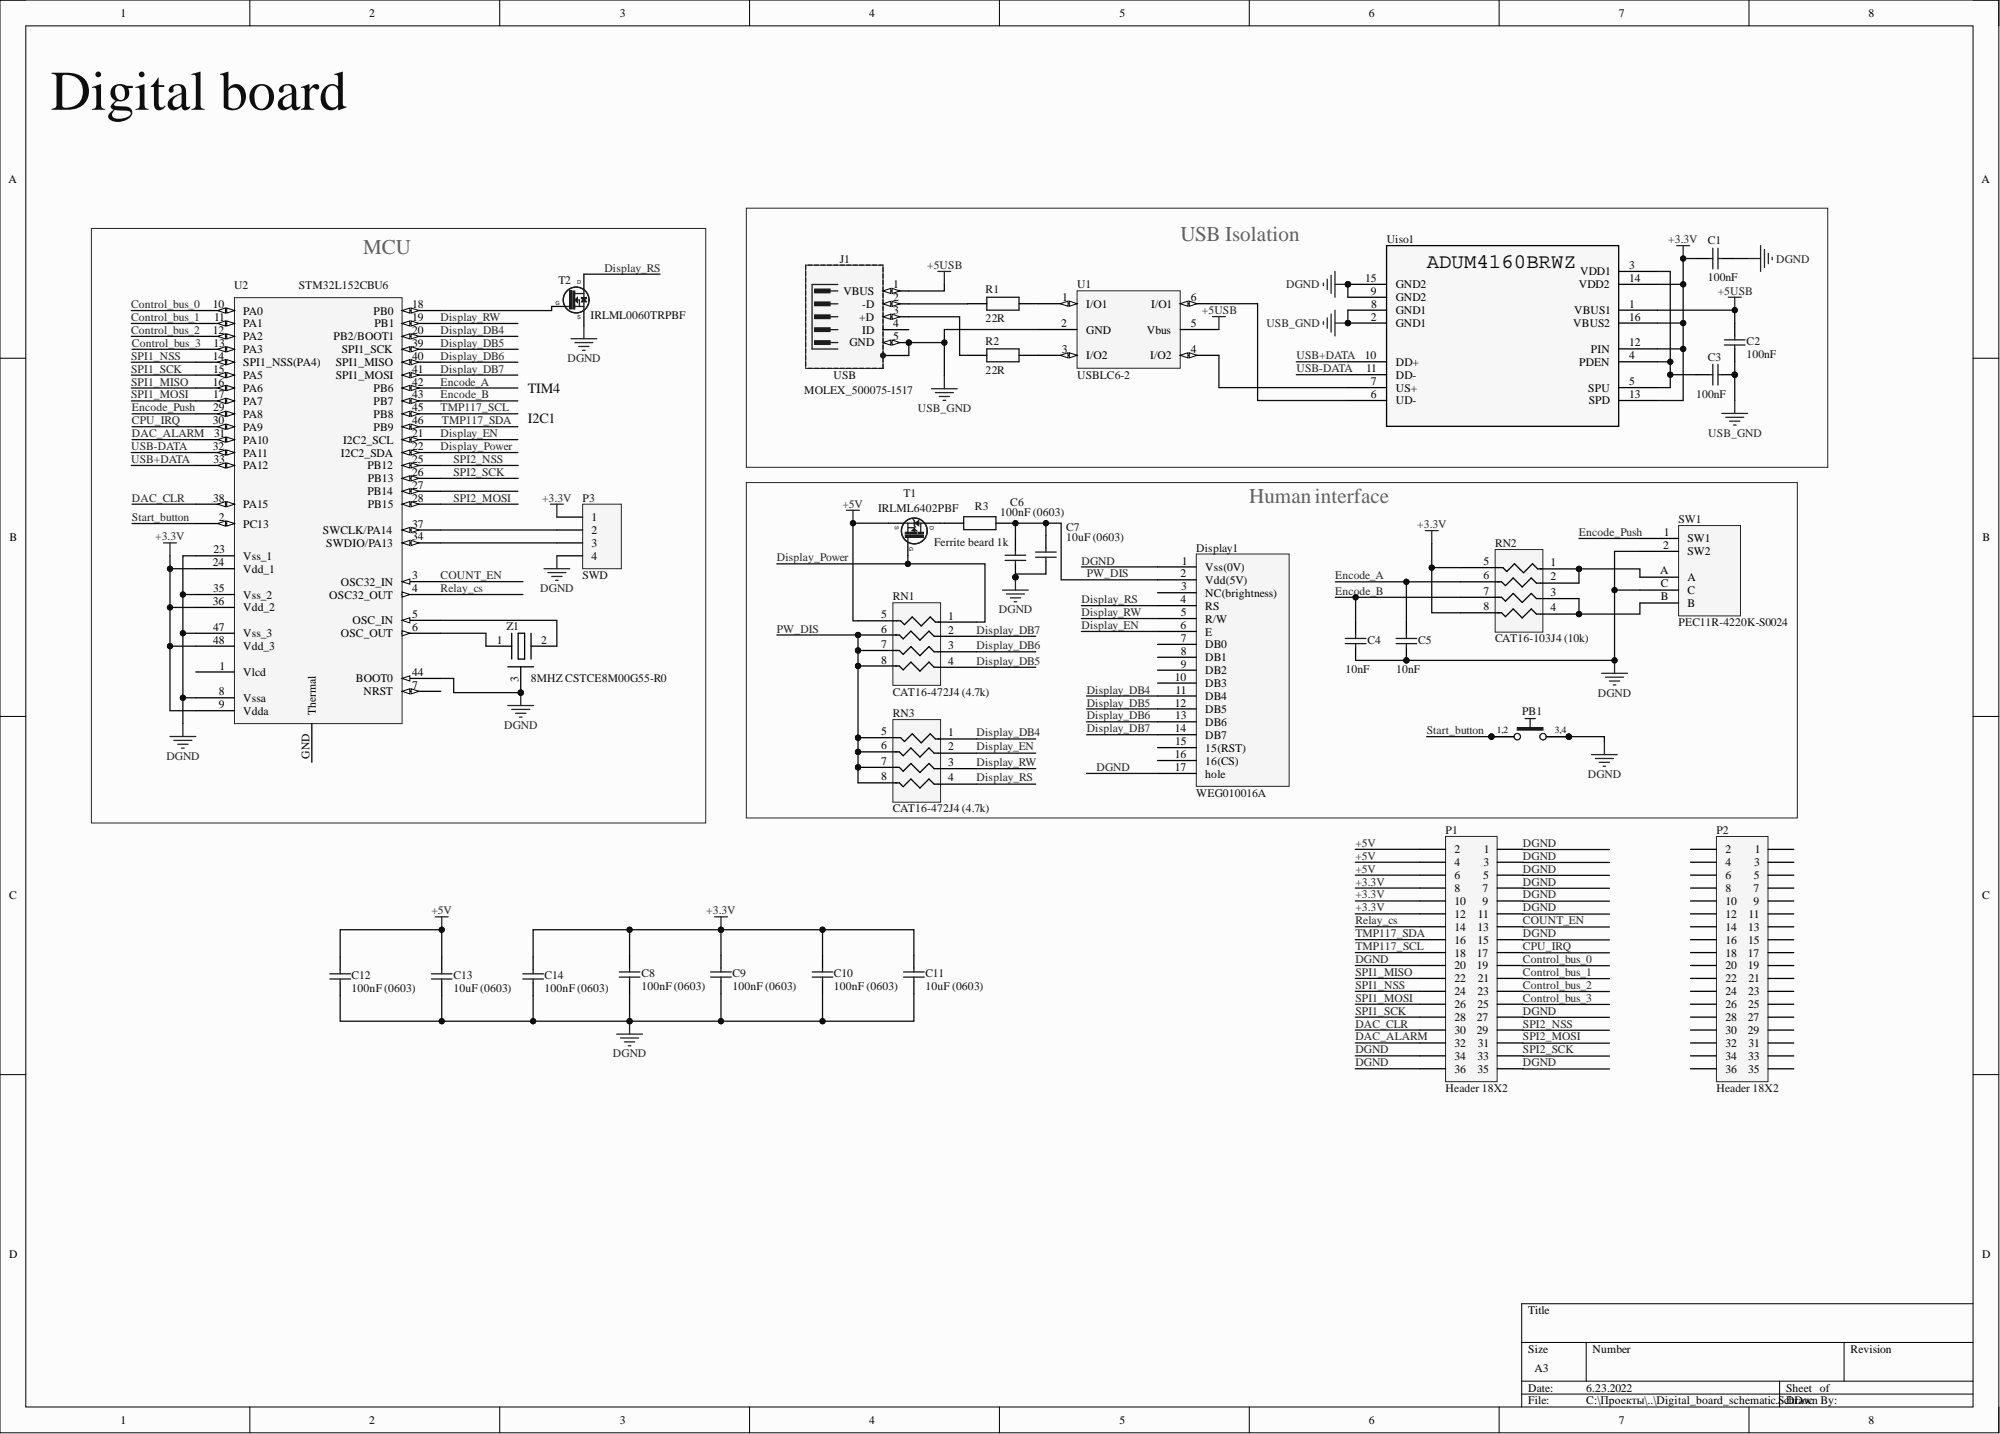
[picture p19: page 1]
