shodanx/Micron-GLIN-v.2/Project_Files/Schematic/External_Power_supply.PDF

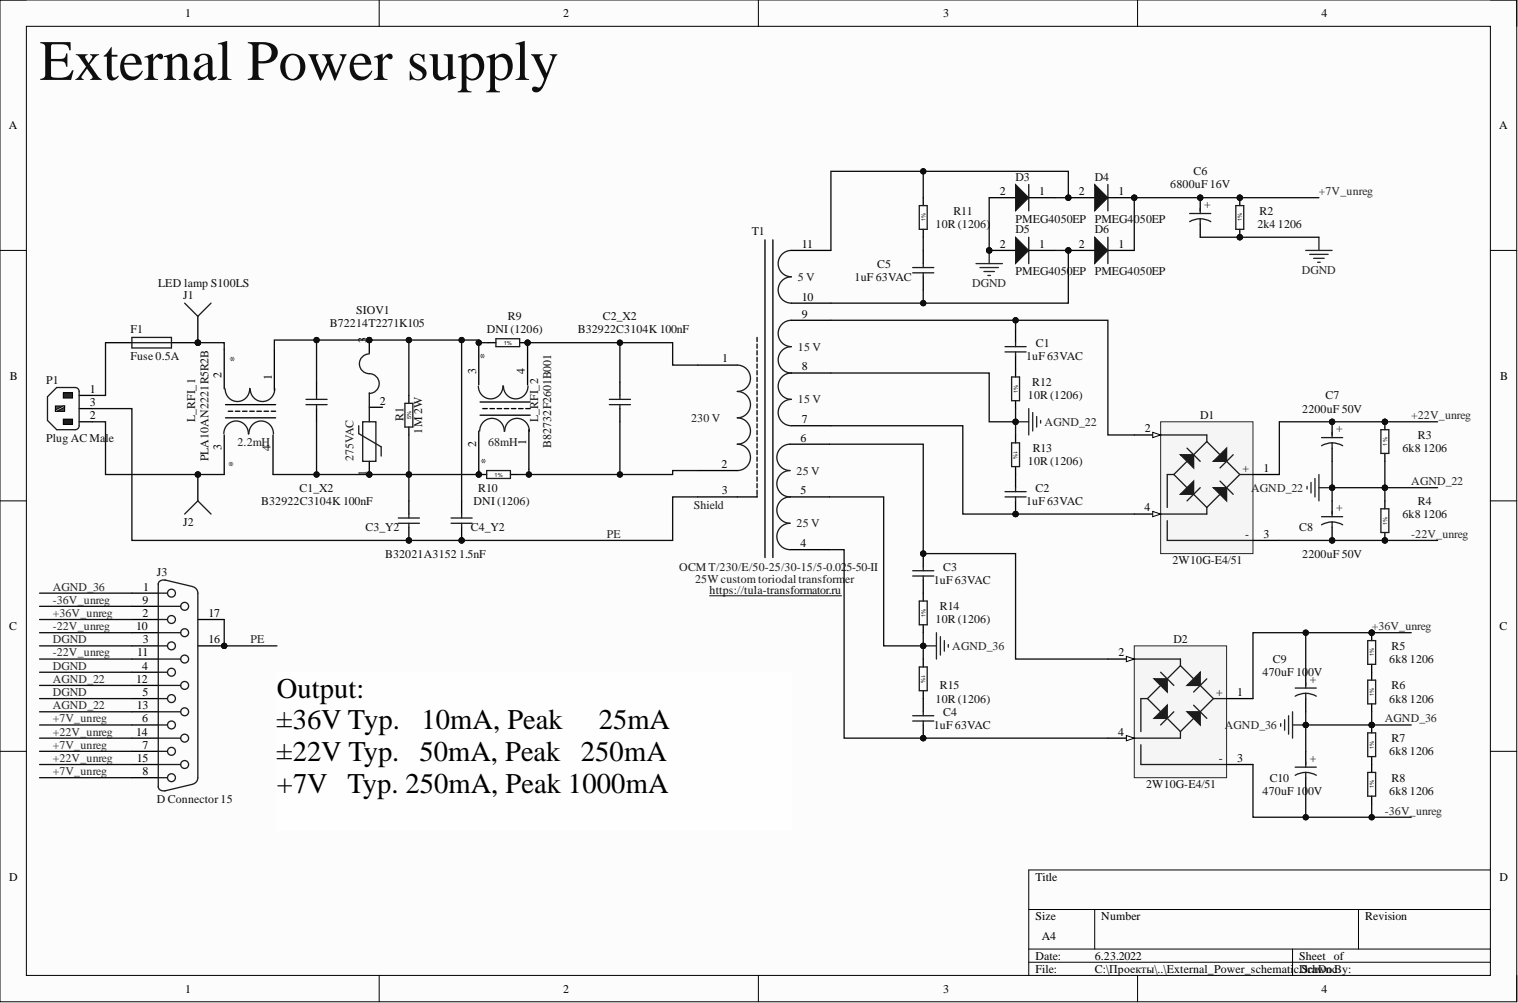
[picture p20: page 1]

OCM T/230/E/50-25/30-15/5-0.025-50-II
25W custom toriodal transformer
https://tula-transformator.ru
