shodanx/Micron-GLIN-v.2/Project_Files/Schematic/Internal Power board.PDF

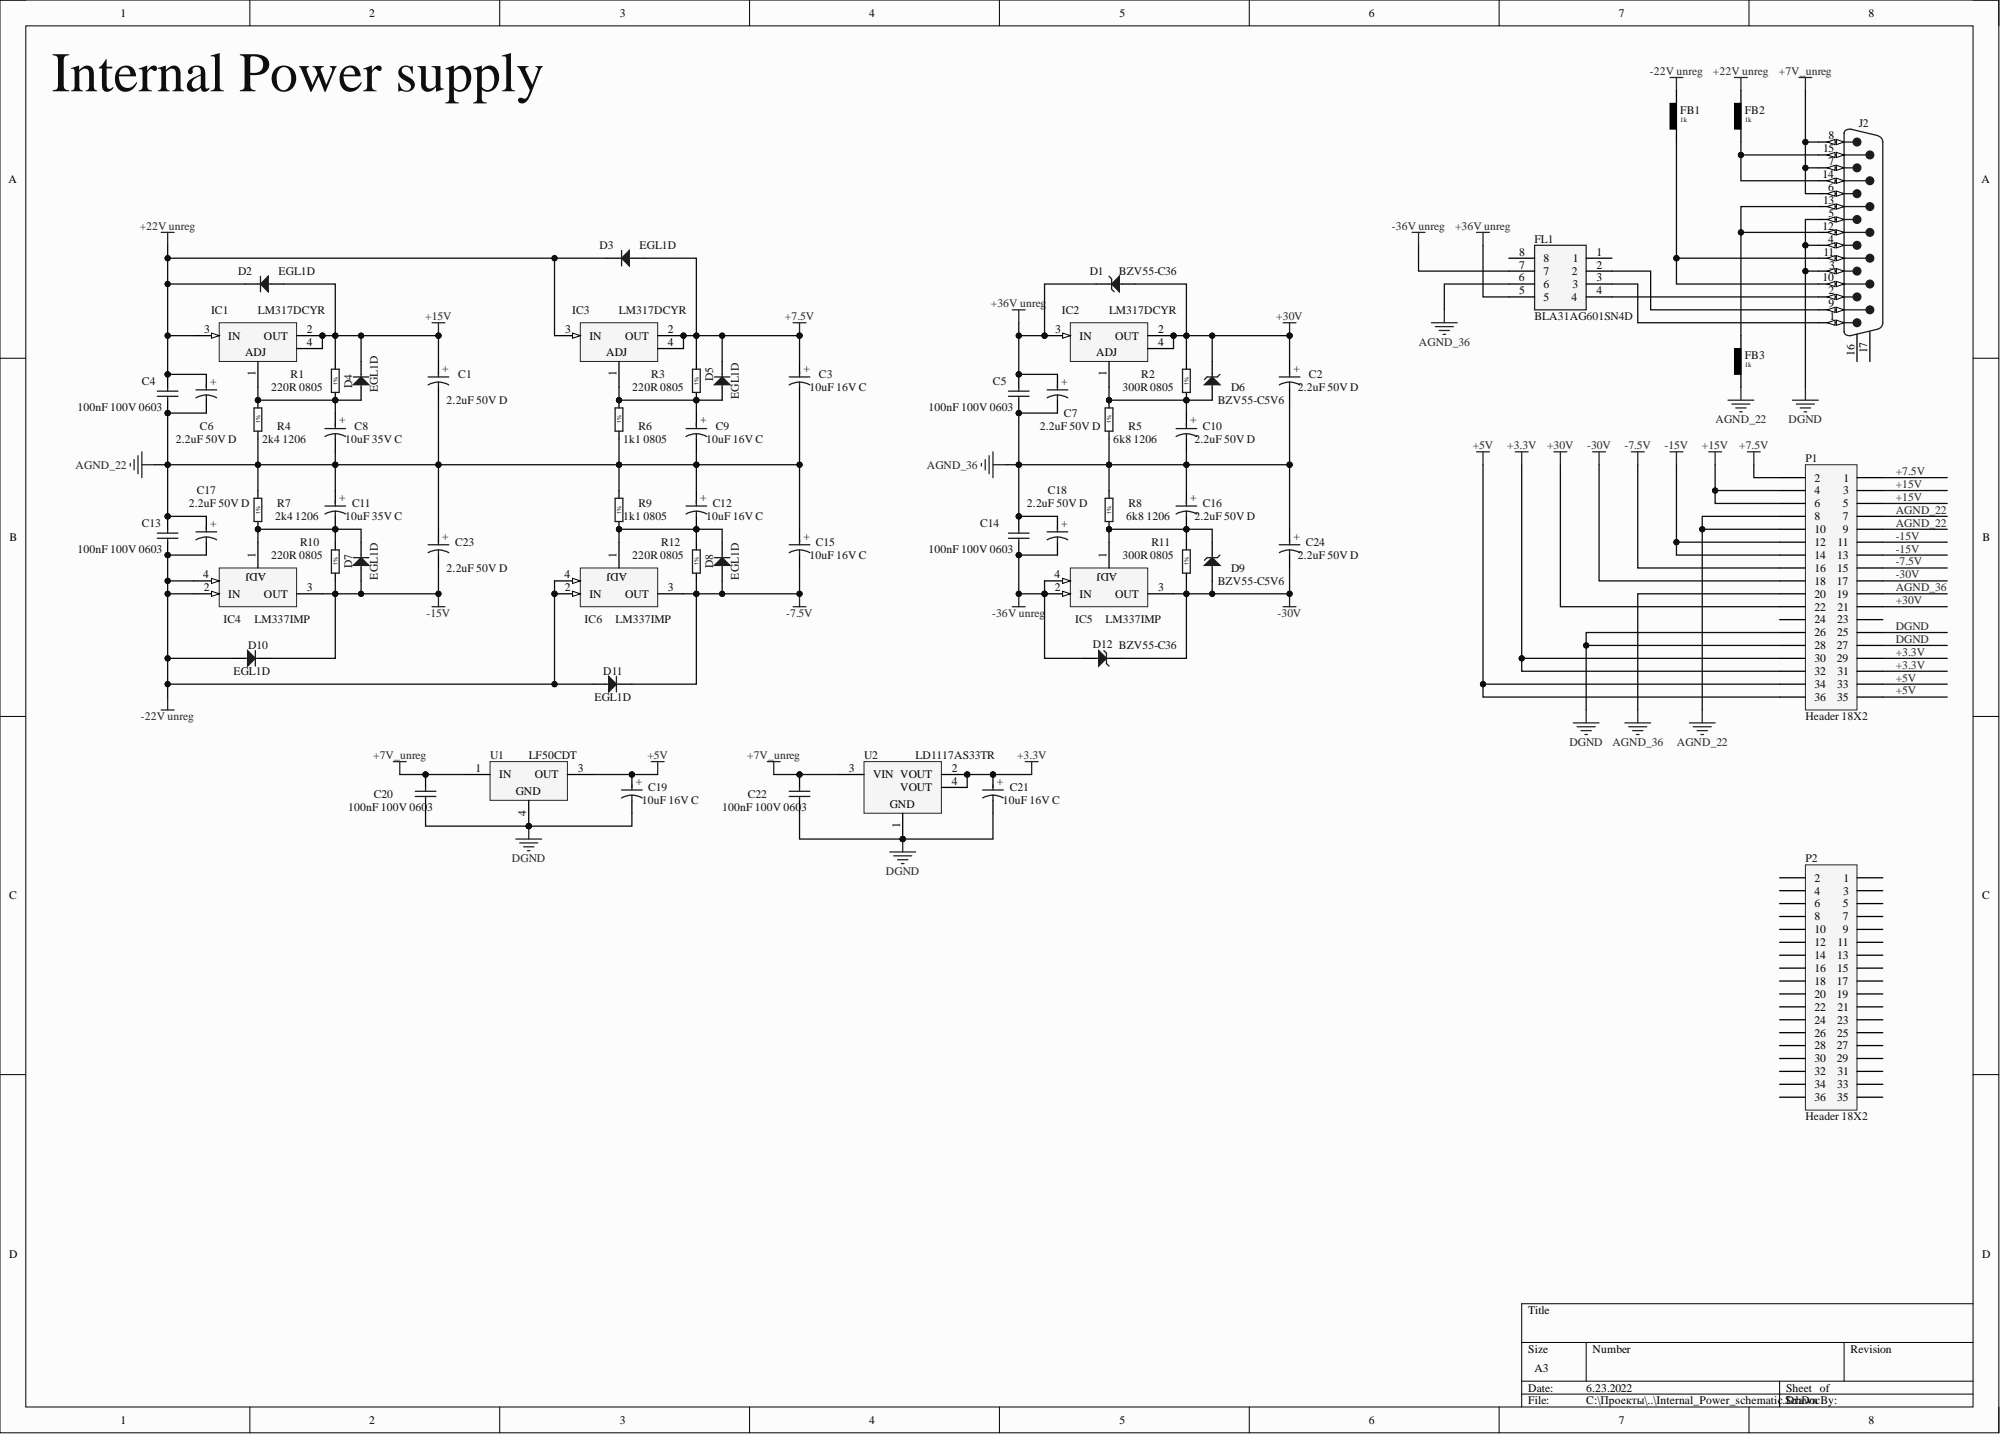
[picture p21: page 1]

15
14

12
