shodanx/Micron-GLIN-v.2/Project_Files/Schematic/Motherboard.PDF

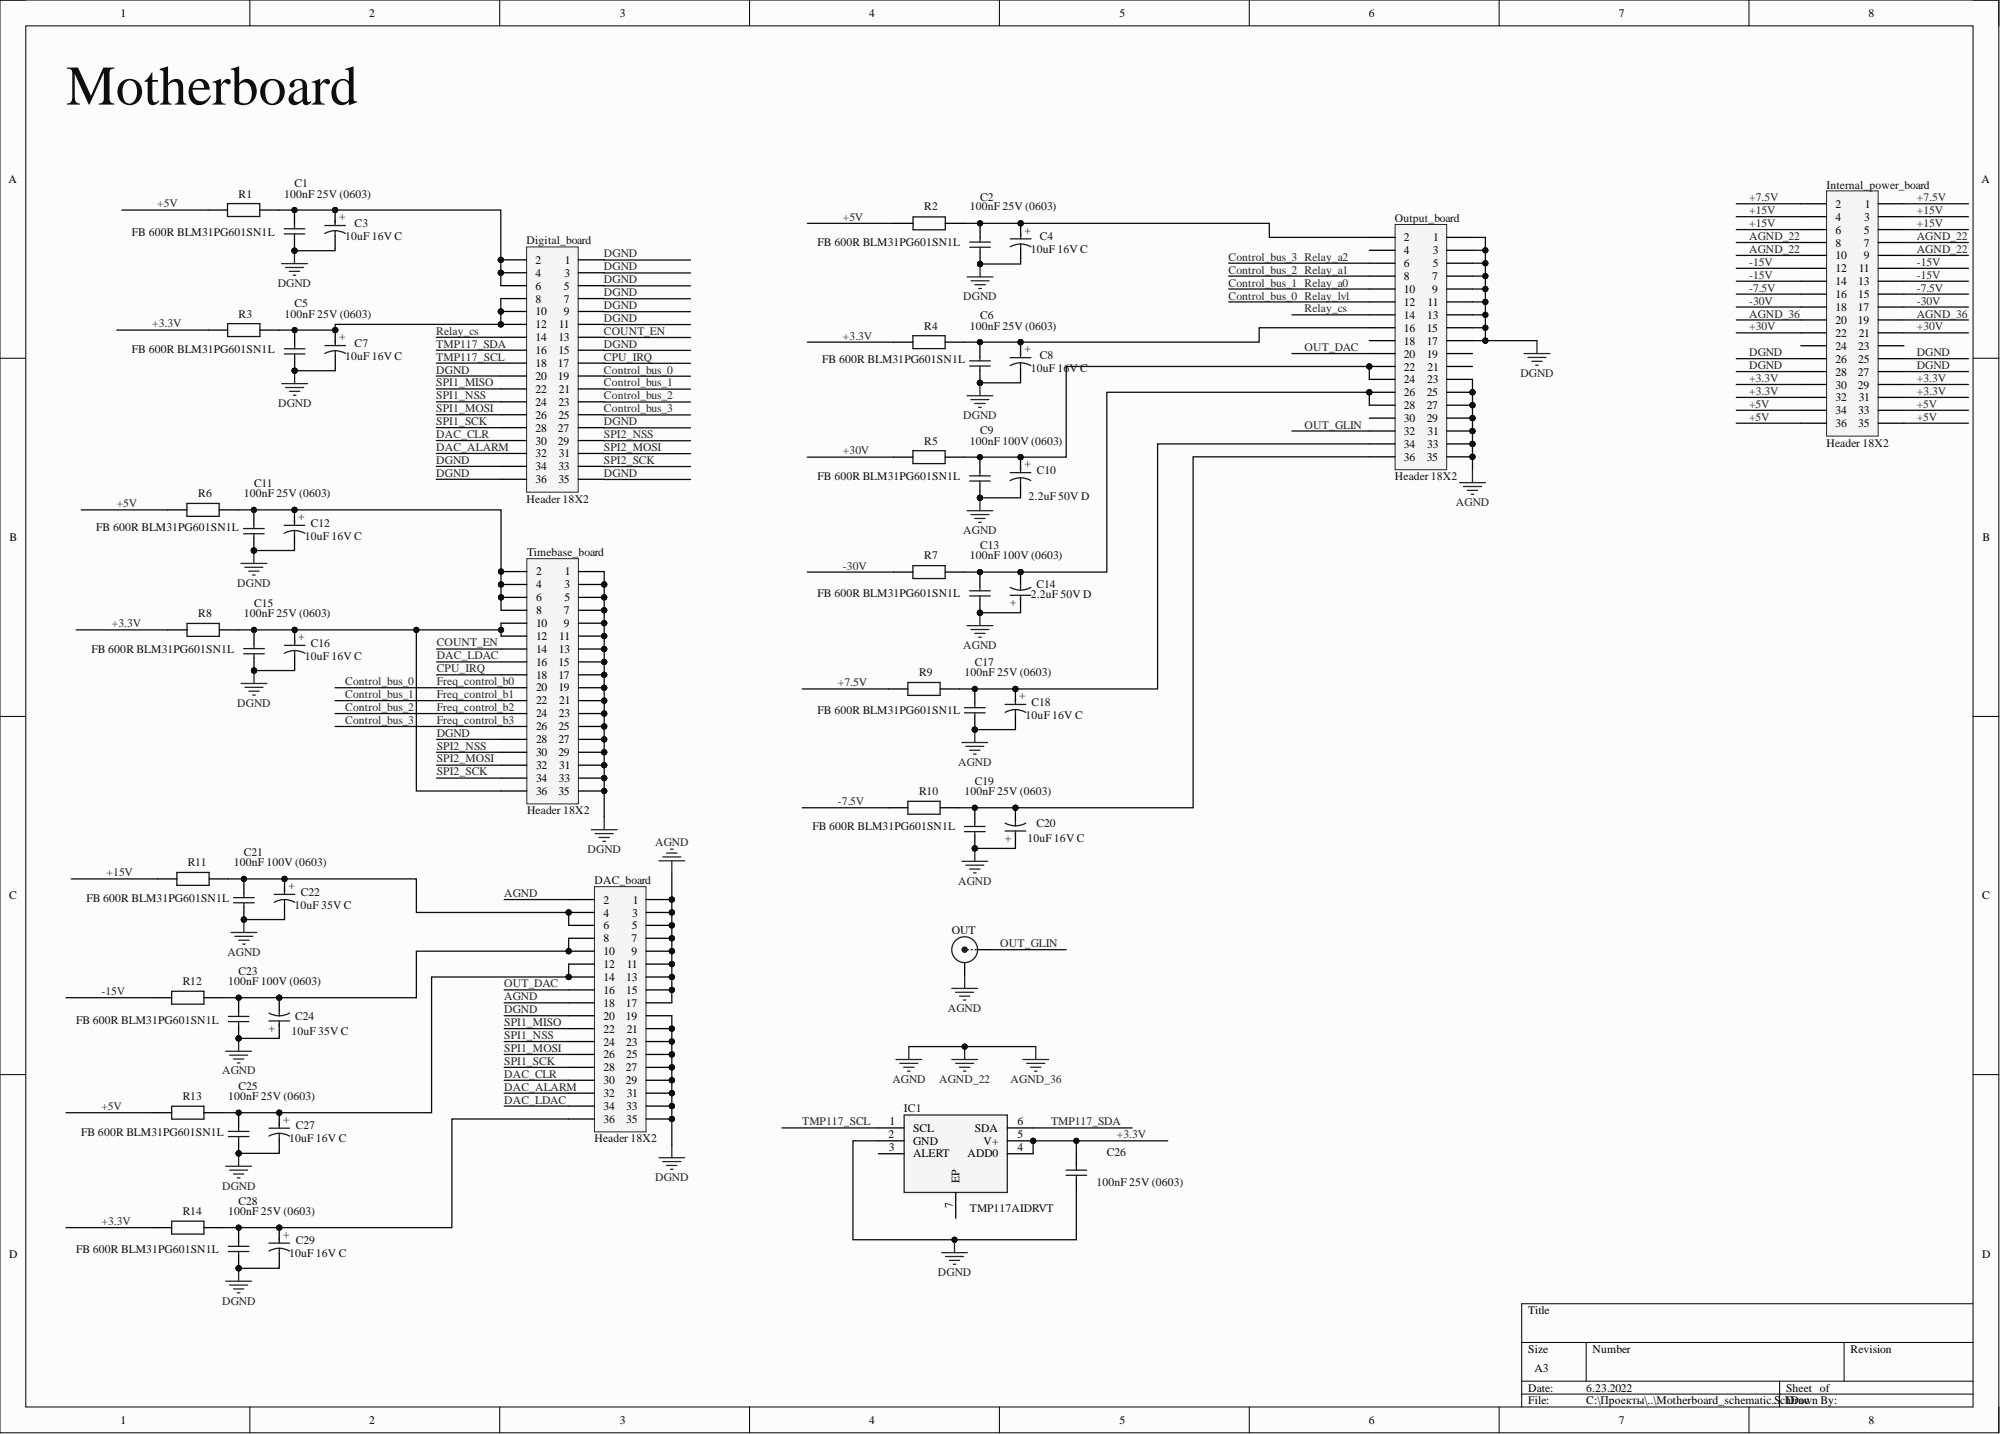
[picture p22: page 1]

Freq_control_b1
Freq_control_b2
Freq_control_b3
DGND
