shodanx/Micron-GLIN-v.2/docs/Simulate_output_stage/output_circ.asc

C1: cap; 680n
C2: cap; 2.2µ
C3: cap; 1n
C4: cap; 2.2µ
C6: cap; 1µ
I_bav99_leakage: current; 700p
I_lin_par_1V/s: current; 0.68µ
IC2: LTC2057HV
L1: FerriteBead; 1.59µ; Ipk=0.2 Rser=75m Cpar=0
R1: res; 4.5k
R4: res; 12k
R5: res; 11k
R6: res; 1k
R17: res; 200R
R18: res; 1K
R_ext_reference: res; 10Meg
U1: LTC2057HV
U2: LT5400-1
V1: voltage; 30V
V2: voltage; 30V
V3: voltage; 6.5
V4: voltage; 30V
V5: voltage; 30V
Named nets: 0, Sense, Force, IN, OUT
;tran 5
V(in)-V(out)
.noise V(OUT) V3 dec 1000 1m 100k
