shodanx/Micron-GLIN-v.2/(list of files, drawings)

Other design files:
Active_GLONASS_GPS_antenna/PCB_Project/AntennaPCB.PcbDoc
Active_GLONASS_GPS_antenna/PCB_Project/AntennaSchematic.SchDoc
Active_GLONASS_GPS_antenna/PCB_Project/GNSS-Antenna.PrjPcb
DAC_board_4layer/DAC_board.PrjPcb
DAC_board_4layer/DAC_board_PCB.PcbDoc
DAC_board_4layer/DAC_board_schematic.SchDoc
Digital_board_4layer/Digital board.PrjPcb
Digital_board_4layer/Digital_board_PCB.PcbDoc
Digital_board_4layer/Digital_board_schematic.SchDoc
docs/main_transformer V3.SchDoc
docs/main_transformer.SchDoc
External_power_board_2layer(Kradex Z4 case)/External Power supply.PrjPcb
External_power_board_2layer(Kradex Z4 case)/External_Power_PCB.PcbDoc
External_power_board_2layer(Kradex Z4 case)/External_Power_schematic.SchDoc
Front_panel_Alliminium_5025/Aluminium Front Panel.PcbDoc
Front_panel_Alliminium_5025/Aluminium Front Panel.PrjPcb
Front_panel_Alliminium_5025/null.SchDoc
Internal_power_board_1layer_Alluminius 5025/Internal Power board.PrjPcb
Internal_power_board_1layer_Alluminius 5025/Internal_Power_PCB.PcbDoc
Internal_power_board_1layer_Alluminius 5025/Internal_Power_schematic.SchDoc
Motherboard_4layer/Motherboard.PrjPcb
Motherboard_4layer/Motherboard_PCB.PcbDoc
Motherboard_4layer/Motherboard_schematic.SchDoc
Output_module_4layer/Output board.PrjPcb
Output_module_4layer/Output_PCB.PcbDoc
Output_module_4layer/Output_schematic.SchDoc
Timebase_board_4layer/Timebase board.PrjPcb
Timebase_board_4layer/Timebase_PCB.PcbDoc
Timebase_board_4layer/Timebase_shcematics.SchDoc
