shodanx/Micron-GLIN-v.2/Timebase_CPLD_software/Timebase_CPLD/sch.vhd

--------------------------------------------------------------------------------
-- Copyright (c) 1995-2013 Xilinx, Inc.  All rights reserved.
--------------------------------------------------------------------------------
--   ____  ____ 
--  /   /\/   / 
-- /___/  \  /    Vendor: Xilinx 
-- \   \   \/     Version : 14.7
--  \   \         Application : sch2hdl
--  /   /         Filename : sch.vhf
-- /___/   /\     Timestamp : 05/09/2022 17:28:07
-- \   \  /  \ 
--  \___\/\___\ 
--
--Command: sch2hdl -intstyle ise -family xc9500xl -flat -suppress -vhdl Z:/Timebase_CPLD/sch.vhf -w Z:/Timebase_CPLD/sch.sch
--Design Name: sch
--Device: xc9500xl
--Purpose:
--    This vhdl netlist is translated from an ECS schematic. It can be 
--    synthesized and simulated, but it should not be modified. 
--

library ieee;
use ieee.std_logic_1164.ALL;
use ieee.numeric_std.ALL;
library UNISIM;
use UNISIM.Vcomponents.ALL;

entity D2_4E_MXILINX_sch is
   port ( A0 : in    std_logic; 
          A1 : in    std_logic; 
          E  : in    std_logic; 
          D0 : out   std_logic; 
          D1 : out   std_logic; 
          D2 : out   std_logic; 
          D3 : out   std_logic);
end D2_4E_MXILINX_sch;

architecture BEHAVIORAL of D2_4E_MXILINX_sch is
   attribute BOX_TYPE   : string ;
   component AND3
      port ( I0 : in    std_logic; 
             I1 : in    std_logic; 
             I2 : in    std_logic; 
             O  : out   std_logic);
   end component;
   attribute BOX_TYPE of AND3 : component is "BLACK_BOX";
   
   component AND3B1
      port ( I0 : in    std_logic; 
             I1 : in    std_logic; 
             I2 : in    std_logic; 
             O  : out   std_logic);
   end component;
   attribute BOX_TYPE of AND3B1 : component is "BLACK_BOX";
   
   component AND3B2
      port ( I0 : in    std_logic; 
             I1 : in    std_logic; 
             I2 : in    std_logic; 
             O  : out   std_logic);
   end component;
   attribute BOX_TYPE of AND3B2 : component is "BLACK_BOX";
   
begin
   I_36_30 : AND3
      port map (I0=>A1,
                I1=>A0,
                I2=>E,
                O=>D3);
   
   I_36_31 : AND3B1
      port map (I0=>A0,
                I1=>A1,
                I2=>E,
                O=>D2);
   
   I_36_32 : AND3B1
      port map (I0=>A1,
                I1=>A0,
                I2=>E,
                O=>D1);
   
   I_36_33 : AND3B2
      port map (I0=>A0,
                I1=>A1,
                I2=>E,
                O=>D0);
   
end BEHAVIORAL;



library ieee;
use ieee.std_logic_1164.ALL;
use ieee.numeric_std.ALL;
library UNISIM;
use UNISIM.Vcomponents.ALL;

entity FTCE_MXILINX_sch is
   generic( INIT : bit :=  '0');
   port ( C   : in    std_logic; 
          CE  : in    std_logic; 
          CLR : in    std_logic; 
          T   : in    std_logic; 
          Q   : out   std_logic);
end FTCE_MXILINX_sch;

architecture BEHAVIORAL of FTCE_MXILINX_sch is
   attribute BOX_TYPE       : string ;
   signal TQ      : std_logic;
   signal Q_DUMMY : std_logic;
   component XOR2
      port ( I0 : in    std_logic; 
             I1 : in    std_logic; 
             O  : out   std_logic);
   end component;
   attribute BOX_TYPE of XOR2 : component is "BLACK_BOX";
   
   component FDCE
      generic( INIT : bit :=  '0');
      port ( C   : in    std_logic; 
             CE  : in    std_logic; 
             CLR : in    std_logic; 
             D   : in    std_logic; 
             Q   : out   std_logic);
   end component;
   attribute BOX_TYPE of FDCE : component is "BLACK_BOX";
   
begin
   Q <= Q_DUMMY;
   I_36_32 : XOR2
      port map (I0=>T,
                I1=>Q_DUMMY,
                O=>TQ);
   
   I_36_35 : FDCE
   generic map( INIT => INIT)
      port map (C=>C,
                CE=>CE,
                CLR=>CLR,
                D=>TQ,
                Q=>Q_DUMMY);
   
end BEHAVIORAL;



library ieee;
use ieee.std_logic_1164.ALL;
use ieee.numeric_std.ALL;
library UNISIM;
use UNISIM.Vcomponents.ALL;

entity CB2CE_MXILINX_sch is
   port ( C   : in    std_logic; 
          CE  : in    std_logic; 
          CLR : in    std_logic; 
          CEO : out   std_logic; 
          Q0  : out   std_logic; 
          Q1  : out   std_logic; 
          TC  : out   std_logic);
end CB2CE_MXILINX_sch;

architecture BEHAVIORAL of CB2CE_MXILINX_sch is
   attribute BOX_TYPE   : string ;
   attribute HU_SET     : string ;
   signal XLXN_1   : std_logic;
   signal Q0_DUMMY : std_logic;
   signal Q1_DUMMY : std_logic;
   signal TC_DUMMY : std_logic;
   component AND2
      port ( I0 : in    std_logic; 
             I1 : in    std_logic; 
             O  : out   std_logic);
   end component;
   attribute BOX_TYPE of AND2 : component is "BLACK_BOX";
   
   component VCC
      port ( P : out   std_logic);
   end component;
   attribute BOX_TYPE of VCC : component is "BLACK_BOX";
   
   component FTCE_MXILINX_sch
      generic( INIT : bit :=  '0');
      port ( C   : in    std_logic; 
             CE  : in    std_logic; 
             CLR : in    std_logic; 
             T   : in    std_logic; 
             Q   : out   std_logic);
   end component;
   
   attribute HU_SET of U0 : label is "U0_0";
   attribute HU_SET of U1 : label is "U1_1";
begin
   Q0 <= Q0_DUMMY;
   Q1 <= Q1_DUMMY;
   TC <= TC_DUMMY;
   I_36_37 : AND2
      port map (I0=>Q1_DUMMY,
                I1=>Q0_DUMMY,
                O=>TC_DUMMY);
   
   I_36_47 : VCC
      port map (P=>XLXN_1);
   
   I_36_52 : AND2
      port map (I0=>CE,
                I1=>TC_DUMMY,
                O=>CEO);
   
   U0 : FTCE_MXILINX_sch
      port map (C=>C,
                CE=>CE,
                CLR=>CLR,
                T=>XLXN_1,
                Q=>Q0_DUMMY);
   
   U1 : FTCE_MXILINX_sch
      port map (C=>C,
                CE=>CE,
                CLR=>CLR,
                T=>Q0_DUMMY,
                Q=>Q1_DUMMY);
   
end BEHAVIORAL;



library ieee;
use ieee.std_logic_1164.ALL;
use ieee.numeric_std.ALL;
library UNISIM;
use UNISIM.Vcomponents.ALL;

entity D4_16E_MXILINX_sch is
   port ( A0  : in    std_logic; 
          A1  : in    std_logic; 
          A2  : in    std_logic; 
          A3  : in    std_logic; 
          E   : in    std_logic; 
          D0  : out   std_logic; 
          D1  : out   std_logic; 
          D2  : out   std_logic; 
          D3  : out   std_logic; 
          D4  : out   std_logic; 
          D5  : out   std_logic; 
          D6  : out   std_logic; 
          D7  : out   std_logic; 
          D8  : out   std_logic; 
          D9  : out   std_logic; 
          D10 : out   std_logic; 
          D11 : out   std_logic; 
          D12 : out   std_logic; 
          D13 : out   std_logic; 
          D14 : out   std_logic; 
          D15 : out   std_logic);
end D4_16E_MXILINX_sch;

architecture BEHAVIORAL of D4_16E_MXILINX_sch is
   attribute BOX_TYPE   : string ;
   component AND5B3
      port ( I0 : in    std_logic; 
             I1 : in    std_logic; 
             I2 : in    std_logic; 
             I3 : in    std_logic; 
             I4 : in    std_logic; 
             O  : out   std_logic);
   end component;
   attribute BOX_TYPE of AND5B3 : component is "BLACK_BOX";
   
   component AND5B2
      port ( I0 : in    std_logic; 
             I1 : in    std_logic; 
             I2 : in    std_logic; 
             I3 : in    std_logic; 
             I4 : in    std_logic; 
             O  : out   std_logic);
   end component;
   attribute BOX_TYPE of AND5B2 : component is "BLACK_BOX";
   
   component AND5B1
      port ( I0 : in    std_logic; 
             I1 : in    std_logic; 
             I2 : in    std_logic; 
             I3 : in    std_logic; 
             I4 : in    std_logic; 
             O  : out   std_logic);
   end component;
   attribute BOX_TYPE of AND5B1 : component is "BLACK_BOX";
   
   component AND5
      port ( I0 : in    std_logic; 
             I1 : in    std_logic; 
             I2 : in    std_logic; 
             I3 : in    std_logic; 
             I4 : in    std_logic; 
             O  : out   std_logic);
   end component;
   attribute BOX_TYPE of AND5 : component is "BLACK_BOX";
   
   component AND5B4
      port ( I0 : in    std_logic; 
             I1 : in    std_logic; 
             I2 : in    std_logic; 
             I3 : in    std_logic; 
             I4 : in    std_logic; 
             O  : out   std_logic);
   end component;
   attribute BOX_TYPE of AND5B4 : component is "BLACK_BOX";
   
begin
   I_36_53 : AND5B3
      port map (I0=>A0,
                I1=>A1,
                I2=>A2,
                I3=>A3,
                I4=>E,
                O=>D8);
   
   I_36_54 : AND5B2
      port map (I0=>A1,
                I1=>A2,
                I2=>E,
                I3=>A3,
                I4=>A0,
                O=>D9);
   
   I_36_55 : AND5B2
      port map (I0=>A0,
                I1=>A2,
                I2=>E,
                I3=>A3,
                I4=>A1,
                O=>D10);
   
   I_36_56 : AND5B1
      port map (I0=>A2,
                I1=>A0,
                I2=>A1,
                I3=>A3,
                I4=>E,
                O=>D11);
   
   I_36_57 : AND5B2
      port map (I0=>A0,
                I1=>A1,
                I2=>E,
                I3=>A3,
                I4=>A2,
                O=>D12);
   
   I_36_58 : AND5B1
      port map (I0=>A1,
                I1=>A0,
                I2=>A2,
                I3=>A3,
                I4=>E,
                O=>D13);
   
   I_36_59 : AND5B1
      port map (I0=>A0,
                I1=>A1,
                I2=>A2,
                I3=>A3,
                I4=>E,
                O=>D14);
   
   I_36_60 : AND5
      port map (I0=>A3,
                I1=>A2,
                I2=>A1,
                I3=>A0,
                I4=>E,
                O=>D15);
   
   I_36_61 : AND5B2
      port map (I0=>A3,
                I1=>A0,
                I2=>E,
                I3=>A2,
                I4=>A1,
                O=>D6);
   
   I_36_62 : AND5B1
      port map (I0=>A3,
                I1=>A2,
                I2=>A1,
                I3=>A0,
                I4=>E,
                O=>D7);
   
   I_36_63 : AND5B2
      port map (I0=>A3,
                I1=>A1,
                I2=>E,
                I3=>A2,
                I4=>A0,
                O=>D5);
   
   I_36_64 : AND5B3
      port map (I0=>A0,
                I1=>A1,
                I2=>A3,
                I3=>A2,
                I4=>E,
                O=>D4);
   
   I_36_65 : AND5B2
      port map (I0=>A2,
                I1=>A3,
                I2=>E,
                I3=>A0,
                I4=>A1,
                O=>D3);
   
   I_36_66 : AND5B3
      port map (I0=>A0,
                I1=>A3,
                I2=>A2,
                I3=>A1,
                I4=>E,
                O=>D2);
   
   I_36_67 : AND5B3
      port map (I0=>A1,
                I1=>A2,
                I2=>A3,
                I3=>A0,
                I4=>E,
                O=>D1);
   
   I_36_68 : AND5B4
      port map (I0=>A3,
                I1=>A2,
                I2=>A1,
                I3=>A0,
                I4=>E,
                O=>D0);
   
end BEHAVIORAL;



library ieee;
use ieee.std_logic_1164.ALL;
use ieee.numeric_std.ALL;
library UNISIM;
use UNISIM.Vcomponents.ALL;

entity LD4_MXILINX_sch is
   port ( D0 : in    std_logic; 
          D1 : in    std_logic; 
          D2 : in    std_logic; 
          D3 : in    std_logic; 
          G  : in    std_logic; 
          Q0 : out   std_logic; 
          Q1 : out   std_logic; 
          Q2 : out   std_logic; 
          Q3 : out   std_logic);
end LD4_MXILINX_sch;

architecture BEHAVIORAL of LD4_MXILINX_sch is
   attribute BOX_TYPE   : string ;
   component LD
      generic( INIT : bit :=  '0');
      port ( D : in    std_logic; 
             G : in    std_logic; 
             Q : out   std_logic);
   end component;
   attribute BOX_TYPE of LD : component is "BLACK_BOX";
   
begin
   U0 : LD
      port map (D=>D0,
                G=>G,
                Q=>Q0);
   
   U1 : LD
      port map (D=>D1,
                G=>G,
                Q=>Q1);
   
   U2 : LD
      port map (D=>D2,
                G=>G,
                Q=>Q2);
   
   U3 : LD
      port map (D=>D3,
                G=>G,
                Q=>Q3);
   
end BEHAVIORAL;



library ieee;
use ieee.std_logic_1164.ALL;
use ieee.numeric_std.ALL;
library UNISIM;
use UNISIM.Vcomponents.ALL;

entity AND9_MXILINX_sch is
   port ( I0 : in    std_logic; 
          I1 : in    std_logic; 
          I2 : in    std_logic; 
          I3 : in    std_logic; 
          I4 : in    std_logic; 
          I5 : in    std_logic; 
          I6 : in    std_logic; 
          I7 : in    std_logic; 
          I8 : in    std_logic; 
          O  : out   std_logic);
end AND9_MXILINX_sch;

architecture BEHAVIORAL of AND9_MXILINX_sch is
   attribute BOX_TYPE   : string ;
   signal S0 : std_logic;
   signal S1 : std_logic;
   component AND4
      port ( I0 : in    std_logic; 
             I1 : in    std_logic; 
             I2 : in    std_logic; 
             I3 : in    std_logic; 
             O  : out   std_logic);
   end component;
   attribute BOX_TYPE of AND4 : component is "BLACK_BOX";
   
   component AND3
      port ( I0 : in    std_logic; 
             I1 : in    std_logic; 
             I2 : in    std_logic; 
             O  : out   std_logic);
   end component;
   attribute BOX_TYPE of AND3 : component is "BLACK_BOX";
   
begin
   I_36_110 : AND4
      port map (I0=>I0,
                I1=>I1,
                I2=>I2,
                I3=>I3,
                O=>S0);
   
   I_36_127 : AND4
      port map (I0=>I4,
                I1=>I5,
                I2=>I6,
                I3=>I7,
                O=>S1);
   
   I_36_176 : AND3
      port map (I0=>S0,
                I1=>S1,
                I2=>I8,
                O=>O);
   
end BEHAVIORAL;



library ieee;
use ieee.std_logic_1164.ALL;
use ieee.numeric_std.ALL;
library UNISIM;
use UNISIM.Vcomponents.ALL;

entity AND8_MXILINX_sch is
   port ( I0 : in    std_logic; 
          I1 : in    std_logic; 
          I2 : in    std_logic; 
          I3 : in    std_logic; 
          I4 : in    std_logic; 
          I5 : in    std_logic; 
          I6 : in    std_logic; 
          I7 : in    std_logic; 
          O  : out   std_logic);
end AND8_MXILINX_sch;

architecture BEHAVIORAL of AND8_MXILINX_sch is
   attribute BOX_TYPE   : string ;
   signal S0 : std_logic;
   signal S1 : std_logic;
   component AND4
      port ( I0 : in    std_logic; 
             I1 : in    std_logic; 
             I2 : in    std_logic; 
             I3 : in    std_logic; 
             O  : out   std_logic);
   end component;
   attribute BOX_TYPE of AND4 : component is "BLACK_BOX";
   
   component AND2
      port ( I0 : in    std_logic; 
             I1 : in    std_logic; 
             O  : out   std_logic);
   end component;
   attribute BOX_TYPE of AND2 : component is "BLACK_BOX";
   
begin
   I_36_110 : AND4
      port map (I0=>I0,
                I1=>I1,
                I2=>I2,
                I3=>I3,
                O=>S0);
   
   I_36_127 : AND4
      port map (I0=>I4,
                I1=>I5,
                I2=>I6,
                I3=>I7,
                O=>S1);
   
   I_36_142 : AND2
      port map (I0=>S0,
                I1=>S1,
                O=>O);
   
end BEHAVIORAL;



library ieee;
use ieee.std_logic_1164.ALL;
use ieee.numeric_std.ALL;
library UNISIM;
use UNISIM.Vcomponents.ALL;

entity AND7_MXILINX_sch is
   port ( I0 : in    std_logic; 
          I1 : in    std_logic; 
          I2 : in    std_logic; 
          I3 : in    std_logic; 
          I4 : in    std_logic; 
          I5 : in    std_logic; 
          I6 : in    std_logic; 
          O  : out   std_logic);
end AND7_MXILINX_sch;

architecture BEHAVIORAL of AND7_MXILINX_sch is
   attribute BOX_TYPE   : string ;
   signal I36 : std_logic;
   component AND4
      port ( I0 : in    std_logic; 
             I1 : in    std_logic; 
             I2 : in    std_logic; 
             I3 : in    std_logic; 
             O  : out   std_logic);
   end component;
   attribute BOX_TYPE of AND4 : component is "BLACK_BOX";
   
begin
   I_36_69 : AND4
      port map (I0=>I3,
                I1=>I4,
                I2=>I5,
                I3=>I6,
                O=>I36);
   
   I_36_85 : AND4
      port map (I0=>I0,
                I1=>I1,
                I2=>I2,
                I3=>I36,
                O=>O);
   
end BEHAVIORAL;



library ieee;
use ieee.std_logic_1164.ALL;
use ieee.numeric_std.ALL;
library UNISIM;
use UNISIM.Vcomponents.ALL;

entity AND6_MXILINX_sch is
   port ( I0 : in    std_logic; 
          I1 : in    std_logic; 
          I2 : in    std_logic; 
          I3 : in    std_logic; 
          I4 : in    std_logic; 
          I5 : in    std_logic; 
          O  : out   std_logic);
end AND6_MXILINX_sch;

architecture BEHAVIORAL of AND6_MXILINX_sch is
   attribute BOX_TYPE   : string ;
   signal I35 : std_logic;
   component AND3
      port ( I0 : in    std_logic; 
             I1 : in    std_logic; 
             I2 : in    std_logic; 
             O  : out   std_logic);
   end component;
   attribute BOX_TYPE of AND3 : component is "BLACK_BOX";
   
   component AND4
      port ( I0 : in    std_logic; 
             I1 : in    std_logic; 
             I2 : in    std_logic; 
             I3 : in    std_logic; 
             O  : out   std_logic);
   end component;
   attribute BOX_TYPE of AND4 : component is "BLACK_BOX";
   
begin
   I_36_69 : AND3
      port map (I0=>I3,
                I1=>I4,
                I2=>I5,
                O=>I35);
   
   I_36_85 : AND4
      port map (I0=>I0,
                I1=>I1,
                I2=>I2,
                I3=>I35,
                O=>O);
   
end BEHAVIORAL;



library ieee;
use ieee.std_logic_1164.ALL;
use ieee.numeric_std.ALL;
library UNISIM;
use UNISIM.Vcomponents.ALL;

entity FDC_MXILINX_sch is
   generic( INIT : bit :=  '0');
   port ( C   : in    std_logic; 
          CLR : in    std_logic; 
          D   : in    std_logic; 
          Q   : out   std_logic);
end FDC_MXILINX_sch;

architecture BEHAVIORAL of FDC_MXILINX_sch is
   attribute BOX_TYPE   : string ;
   signal XLXN_5 : std_logic;
   component GND
      port ( G : out   std_logic);
   end component;
   attribute BOX_TYPE of GND : component is "BLACK_BOX";
   
   component FDCP
      generic( INIT : bit :=  '0');
      port ( C   : in    std_logic; 
             CLR : in    std_logic; 
             D   : in    std_logic; 
             PRE : in    std_logic; 
             Q   : out   std_logic);
   end component;
   attribute BOX_TYPE of FDCP : component is "BLACK_BOX";
   
begin
   I_36_55 : GND
      port map (G=>XLXN_5);
   
   U0 : FDCP
   generic map( INIT => INIT)
      port map (C=>C,
                CLR=>CLR,
                D=>D,
                PRE=>XLXN_5,
                Q=>Q);
   
end BEHAVIORAL;



library ieee;
use ieee.std_logic_1164.ALL;
use ieee.numeric_std.ALL;
library UNISIM;
use UNISIM.Vcomponents.ALL;

entity CB8X1_MXILINX_sch is
   port ( C    : in    std_logic; 
          CED  : in    std_logic; 
          CEU  : in    std_logic; 
          CLR  : in    std_logic; 
          D    : in    std_logic_vector (7 downto 0); 
          L    : in    std_logic; 
          CEOD : out   std_logic; 
          CEOU : out   std_logic; 
          Q    : out   std_logic_vector (7 downto 0); 
          TCD  : out   std_logic; 
          TCU  : out   std_logic);
end CB8X1_MXILINX_sch;

architecture BEHAVIORAL of CB8X1_MXILINX_sch is
   attribute BOX_TYPE   : string ;
   attribute HU_SET     : string ;
   signal CEU_I     : std_logic;
   signal XLXN_12   : std_logic;
   signal XLXN_13   : std_logic;
   signal XLXN_14   : std_logic;
   signal XLXN_15   : std_logic;
   signal XLXN_16   : std_logic;
   signal XLXN_17   : std_logic;
   signal XLXN_18   : std_logic;
   signal XLXN_19   : std_logic;
   signal XLXN_20   : std_logic;
   signal XLXN_21   : std_logic;
   signal XLXN_22   : std_logic;
   signal XLXN_23   : std_logic;
   signal XLXN_24   : std_logic;
   signal XLXN_25   : std_logic;
   signal XLXN_26   : std_logic;
   signal XLXN_27   : std_logic;
   signal XLXN_28   : std_logic;
   signal XLXN_29   : std_logic;
   signal XLXN_30   : std_logic;
   signal XLXN_31   : std_logic;
   signal XLXN_32   : std_logic;
   signal XLXN_33   : std_logic;
   signal XLXN_34   : std_logic;
   signal XLXN_35   : std_logic;
   signal XLXN_36   : std_logic;
   signal XLXN_37   : std_logic;
   signal XLXN_38   : std_logic;
   signal XLXN_39   : std_logic;
   signal XLXN_40   : std_logic;
   signal XLXN_41   : std_logic;
   signal XLXN_42   : std_logic;
   signal XLXN_43   : std_logic;
   signal XLXN_44   : std_logic;
   signal XLXN_45   : std_logic;
   signal XLXN_46   : std_logic;
   signal XLXN_47   : std_logic;
   signal XLXN_48   : std_logic;
   signal XLXN_49   : std_logic;
   signal XLXN_50   : std_logic;
   signal XLXN_51   : std_logic;
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
             O  : out   std_logic);
   end component;
   attribute BOX_TYPE of OR2 : component is "BLACK_BOX";
   
   component GND
      port ( G : out   std_logic);
   end component;
   attribute BOX_TYPE of GND : component is "BLACK_BOX";
   
   component AND2B2
      port ( I0 : in    std_logic; 
             I1 : in    std_logic; 
             O  : out   std_logic);
   end component;
   attribute BOX_TYPE of AND2B2 : component is "BLACK_BOX";
   
   component NOR4
      port ( I0 : in    std_logic; 
             I1 : in    std_logic; 
             I2 : in    std_logic; 
             I3 : in    std_logic; 
             O  : out   std_logic);
   end component;
   attribute BOX_TYPE of NOR4 : component is "BLACK_BOX";
   
   component FDC_MXILINX_sch
      generic( INIT : bit :=  '0');
      port ( C   : in    std_logic; 
             CLR : in    std_logic; 
             D   : in    std_logic; 
             Q   : out   std_logic);
   end component;
   
   attribute HU_SET of I_36_188 : label is "I_36_188_11";
   attribute HU_SET of I_36_189 : label is "I_36_189_13";
   attribute HU_SET of I_36_190 : label is "I_36_190_17";
   attribute HU_SET of I_36_191 : label is "I_36_191_23";
   attribute HU_SET of I_36_282 : label is "I_36_282_12";
   attribute HU_SET of I_36_346 : label is "I_36_346_14";
   attribute HU_SET of I_36_418 : label is "I_36_418_18";
   attribute HU_SET of I_36_455 : label is "I_36_455_22";
   attribute HU_SET of I_36_489 : label is "I_36_489_21";
   attribute HU_SET of I_36_528 : label is "I_36_528_16";
   attribute HU_SET of I_36_660 : label is "I_36_660_20";
   attribute HU_SET of I_36_704 : label is "I_36_704_19";
   attribute HU_SET of I_36_776 : label is "I_36_776_24";
   attribute HU_SET of I_36_824 : label is "I_36_824_15";
   attribute HU_SET of Q0 : label is "Q0_10";
   attribute HU_SET of Q1 : label is "Q1_9";
   attribute HU_SET of Q2 : label is "Q2_8";
   attribute HU_SET of Q3 : label is "Q3_7";
   attribute HU_SET of Q4 : label is "Q4_6";
   attribute HU_SET of Q5 : label is "Q5_5";
   attribute HU_SET of Q6 : label is "Q6_4";
   attribute HU_SET of Q7 : label is "Q7_3";
   attribute HU_SET of TCDINV : label is "TCDINV_2";
begin
   Q(7 downto 0) <= Q_DUMMY(7 downto 0);
   TCD <= TCD_DUMMY;
   TCU <= TCU_DUMMY;
   I_36_75 : AND2B1
      port map (I0=>XLXN_15,
                I1=>CEU_I,
                O=>XLXN_122);
   
   I_36_76 : AND3B2
      port map (I0=>XLXN_15,
                I1=>CEU_I,
                I2=>XLXN_13,
                O=>XLXN_112);
   
   I_36_77 : AND2
      port map (I0=>D(0),
                I1=>XLXN_15,
                O=>XLXN_62);
   
   I_36_78 : AND2B1
      port map (I0=>XLXN_15,
                I1=>Q_DUMMY(0),
                O=>XLXN_63);
   
   I_36_79 : OR3
      port map (I0=>XLXN_62,
                I1=>XLXN_122,
                I2=>XLXN_112,
                O=>XLXN_111);
   
   I_36_81 : XOR2
      port map (I0=>XLXN_63,
                I1=>XLXN_111,
                O=>XLXN_61);
   
   I_36_108 : AND3B1
      port map (I0=>XLXN_15,
                I1=>Q_DUMMY(0),
                I2=>CEU_I,
                O=>XLXN_123);
   
   I_36_109 : AND4B3
      port map (I0=>Q_DUMMY(0),
                I1=>XLXN_15,
                I2=>CEU_I,
                I3=>XLXN_13,
                O=>XLXN_110);
   
   I_36_111 : AND2
      port map (I0=>D(1),
                I1=>XLXN_15,
                O=>XLXN_108);
   
   I_36_112 : AND2B1
      port map (I0=>XLXN_15,
                I1=>Q_DUMMY(1),
                O=>XLXN_106);
   
   I_36_114 : OR3
      port map (I0=>XLXN_108,
                I1=>XLXN_123,
                I2=>XLXN_110,
                O=>XLXN_107);
   
   I_36_115 : XOR2
      port map (I0=>XLXN_106,
                I1=>XLXN_107,
                O=>XLXN_60);
   
   I_36_144 : AND4B1
      port map (I0=>XLXN_15,
                I1=>Q_DUMMY(1),
                I2=>Q_DUMMY(0),
                I3=>CEU_I,
                O=>XLXN_124);
   
   I_36_145 : AND5B4
      port map (I0=>Q_DUMMY(1),
                I1=>Q_DUMMY(0),
                I2=>XLXN_15,
                I3=>CEU_I,
                I4=>XLXN_13,
                O=>XLXN_109);
   
   I_36_156 : OR3
      port map (I0=>XLXN_105,
                I1=>XLXN_124,
                I2=>XLXN_109,
                O=>XLXN_104);
   
   I_36_157 : AND2B1
      port map (I0=>XLXN_15,
                I1=>Q_DUMMY(2),
                O=>XLXN_103);
   
   I_36_158 : AND2
      port map (I0=>D(2),
                I1=>XLXN_15,
                O=>XLXN_105);
   
   I_36_173 : XOR2
      port map (I0=>XLXN_103,
                I1=>XLXN_104,
                O=>XLXN_59);
   
   I_36_188 : AND6_MXILINX_sch
      port map (I0=>XLXN_102,
                I1=>XLXN_116,
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
      port map (I0=>Q_DUMMY(0),
                I1=>Q_DUMMY(1),
                I2=>Q_DUMMY(2),
                I3=>Q_DUMMY(3),
                I4=>Q_DUMMY(4),
                I5=>Q_DUMMY(5),
                I6=>Q_DUMMY(6),
                I7=>Q_DUMMY(7),
                O=>XLXN_12);
   
   Q0 : FDC_MXILINX_sch
      port map (C=>C,
                CLR=>CLR,
                D=>XLXN_61,
                Q=>Q_DUMMY(0));
   
   Q1 : FDC_MXILINX_sch
      port map (C=>C,
                CLR=>CLR,
                D=>XLXN_60,
                Q=>Q_DUMMY(1));
   
   Q2 : FDC_MXILINX_sch
      port map (C=>C,
                CLR=>CLR,
                D=>XLXN_59,
                Q=>Q_DUMMY(2));
   
   Q3 : FDC_MXILINX_sch
      port map (C=>C,
                CLR=>CLR,
                D=>XLXN_58,
                Q=>Q_DUMMY(3));
   
   Q4 : FDC_MXILINX_sch
      port map (C=>C,
                CLR=>CLR,
                D=>XLXN_57,
                Q=>Q_DUMMY(4));
   
   Q5 : FDC_MXILINX_sch
      port map (C=>C,
                CLR=>CLR,
                D=>XLXN_56,
                Q=>Q_DUMMY(5));
   
   Q6 : FDC_MXILINX_sch
      port map (C=>C,
                CLR=>CLR,
                D=>XLXN_55,
                Q=>Q_DUMMY(6));
   
   Q7 : FDC_MXILINX_sch
      port map (C=>C,
                CLR=>CLR,
                D=>XLXN_20,
                Q=>Q_DUMMY(7));
   
   TCDINV : FDC_MXILINX_sch
      port map (C=>C,
                CLR=>CLR,
                D=>XLXN_19,
                Q=>XLXN_14);
   
end BEHAVIORAL;



library ieee;
use ieee.std_logic_1164.ALL;
use ieee.numeric_std.ALL;
library UNISIM;
use UNISIM.Vcomponents.ALL;

entity CB16X1_MXILINX_sch is
   port ( C    : in    std_logic; 
          CED  : in    std_logic; 
          CEU  : in    std_logic; 
          CLR  : in    std_logic; 
          D    : in    std_logic_vector (15 downto 0); 
          L    : in    std_logic; 
          CEOD : out   std_logic; 
          CEOU : out   std_logic; 
          Q    : out   std_logic_vector (15 downto 0); 
          TCD  : out   std_logic; 
          TCU  : out   std_logic);
end CB16X1_MXILINX_sch;

architecture BEHAVIORAL of CB16X1_MXILINX_sch is
   attribute HU_SET     : string ;
   attribute BOX_TYPE   : string ;
   signal XLXN_15 : std_logic;
   signal XLXN_16 : std_logic;
   signal XLXN_17 : std_logic;
   signal XLXN_18 : std_logic;
   signal XLXN_19 : std_logic;
   signal XLXN_20 : std_logic;
   component CB8X1_MXILINX_sch
      port ( C    : in    std_logic; 
             CED  : in    std_logic; 
             CEU  : in    std_logic; 
             CLR  : in    std_logic; 
             D    : in    std_logic_vector (7 downto 0); 
             L    : in    std_logic; 
             CEOD : out   std_logic; 
             CEOU : out   std_logic; 
             Q    : out   std_logic_vector (7 downto 0); 
             TCD  : out   std_logic; 
             TCU  : out   std_logic);
   end component;
   
   component AND2
      port ( I0 : in    std_logic; 
             I1 : in    std_logic; 
             O  : out   std_logic);
   end component;
   attribute BOX_TYPE of AND2 : component is "BLACK_BOX";
   
   attribute HU_SET of CB0 : label is "CB0_25";
   attribute HU_SET of CB8 : label is "CB8_26";
begin
   CB0 : CB8X1_MXILINX_sch
      port map (C=>C,
                CED=>CED,
                CEU=>CEU,
                CLR=>CLR,
                D(7 downto 0)=>D(7 downto 0),
                L=>L,
                CEOD=>XLXN_19,
                CEOU=>XLXN_20,
                Q(7 downto 0)=>Q(7 downto 0),
                TCD=>XLXN_18,
                TCU=>XLXN_16);
   
   CB8 : CB8X1_MXILINX_sch
      port map (C=>C,
                CED=>XLXN_19,
                CEU=>XLXN_20,
                CLR=>CLR,
                D(7 downto 0)=>D(15 downto 8),
                L=>L,
                CEOD=>CEOD,
                CEOU=>CEOU,
                Q(7 downto 0)=>Q(15 downto 8),
                TCD=>XLXN_17,
                TCU=>XLXN_15);
   
   I_36_165 : AND2
      port map (I0=>XLXN_15,
                I1=>XLXN_16,
                O=>TCU);
   
   I_36_166 : AND2
      port map (I0=>XLXN_17,
                I1=>XLXN_18,
                O=>TCD);
   
end BEHAVIORAL;



library ieee;
use ieee.std_logic_1164.ALL;
use ieee.numeric_std.ALL;
library UNISIM;
use UNISIM.Vcomponents.ALL;

entity sch is
   port ( COUNT_EN     : in    std_logic; 
          DDS_FREQ     : in    std_logic; 
          Freq_control : in    std_logic_vector (3 downto 0); 
          IN_10MHz     : in    std_logic; 
          CPU_IRQ      : out   std_logic; 
          DAC_LDAC     : out   std_logic);
end sch;

architecture BEHAVIORAL of sch is
   attribute HU_SET     : string ;
   attribute BOX_TYPE   : string ;
   signal Block_IRQ_afrer_timeout                    : std_logic;
   signal Block_timer_after_overload_until_new_cycle : std_logic;
   signal CFG_N                                      : std_logic_vector (15 
         downto 0);
   signal dds_timer_OL                               : std_logic;
   signal Delay_plus_100ns                           : std_logic;
   signal Delay_0_to_100ns                           : std_logic;
   signal Hold_IRQ_after_LDAC                        : std_logic;
   signal Hold_LDAC_100ns_to_200ns                   : std_logic;
   signal Output_enable                              : std_logic;
   signal XLXN_110                                   : std_logic;
   signal XLXN_111                                   : std_logic;
   signal XLXN_168                                   : std_logic;
   signal XLXN_171                                   : std_logic;
   signal XLXN_175                                   : std_logic;
   signal XLXN_176                                   : std_logic;
   signal XLXN_203                                   : std_logic;
   signal XLXN_204                                   : std_logic;
   signal XLXN_222                                   : std_logic;
   signal XLXN_226                                   : std_logic;
   signal XLXN_228                                   : std_logic;
   signal XLXN_239                                   : std_logic;
   signal XLXN_243                                   : std_logic;
   signal XLXN_245                                   : std_logic;
   signal XLXN_246                                   : std_logic;
   signal XLXN_247                                   : std_logic;
   signal XLXN_248                                   : std_logic;
   signal XLXN_260                                   : std_logic;
   component D4_16E_MXILINX_sch
      port ( A0  : in    std_logic; 
             A1  : in    std_logic; 
             A2  : in    std_logic; 
             A3  : in    std_logic; 
             E   : in    std_logic; 
             D0  : out   std_logic; 
             D1  : out   std_logic; 
             D10 : out   std_logic; 
             D11 : out   std_logic; 
             D12 : out   std_logic; 
             D13 : out   std_logic; 
             D14 : out   std_logic; 
             D15 : out   std_logic; 
             D2  : out   std_logic; 
             D3  : out   std_logic; 
             D4  : out   std_logic; 
             D5  : out   std_logic; 
             D6  : out   std_logic; 
             D7  : out   std_logic; 
             D8  : out   std_logic; 
             D9  : out   std_logic);
   end component;
   
   component CB16X1_MXILINX_sch
      port ( C    : in    std_logic; 
             CED  : in    std_logic; 
             CEU  : in    std_logic; 
             CLR  : in    std_logic; 
             D    : in    std_logic_vector (15 downto 0); 
             L    : in    std_logic; 
             CEOD : out   std_logic; 
             CEOU : out   std_logic; 
             Q    : out   std_logic_vector (15 downto 0); 
             TCD  : out   std_logic; 
             TCU  : out   std_logic);
   end component;
   
   component INV
      port ( I : in    std_logic; 
             O : out   std_logic);
   end component;
   attribute BOX_TYPE of INV : component is "BLACK_BOX";
   
   component AND2
      port ( I0 : in    std_logic; 
             I1 : in    std_logic; 
             O  : out   std_logic);
   end component;
   attribute BOX_TYPE of AND2 : component is "BLACK_BOX";
   
   component VCC
      port ( P : out   std_logic);
   end component;
   attribute BOX_TYPE of VCC : component is "BLACK_BOX";
   
   component GND
      port ( G : out   std_logic);
   end component;
   attribute BOX_TYPE of GND : component is "BLACK_BOX";
   
   component D2_4E_MXILINX_sch
      port ( A0 : in    std_logic; 
             A1 : in    std_logic; 
             E  : in    std_logic; 
             D0 : out   std_logic; 
             D1 : out   std_logic; 
             D2 : out   std_logic; 
             D3 : out   std_logic);
   end component;
   
   component CB2CE_MXILINX_sch
      port ( C   : in    std_logic; 
             CE  : in    std_logic; 
             CLR : in    std_logic; 
             CEO : out   std_logic; 
             Q0  : out   std_logic; 
             Q1  : out   std_logic; 
             TC  : out   std_logic);
   end component;
   
   component OR2
      port ( I0 : in    std_logic; 
             I1 : in    std_logic; 
             O  : out   std_logic);
   end component;
   attribute BOX_TYPE of OR2 : component is "BLACK_BOX";
   
   component BUFG
      port ( I : in    std_logic; 
             O : out   std_logic);
   end component;
   attribute BOX_TYPE of BUFG : component is "BLACK_BOX";
   
   component AND3
      port ( I0 : in    std_logic; 
             I1 : in    std_logic; 
             I2 : in    std_logic; 
             O  : out   std_logic);
   end component;
   attribute BOX_TYPE of AND3 : component is "BLACK_BOX";
   
   component LD4_MXILINX_sch
      port ( D0 : in    std_logic; 
             D1 : in    std_logic; 
             D2 : in    std_logic; 
             D3 : in    std_logic; 
             G  : in    std_logic; 
             Q0 : out   std_logic; 
             Q1 : out   std_logic; 
             Q2 : out   std_logic; 
             Q3 : out   std_logic);
   end component;
   
   attribute HU_SET of XLXI_1 : label is "XLXI_1_29";
   attribute HU_SET of XLXI_12 : label is "XLXI_12_27";
   attribute HU_SET of XLXI_61 : label is "XLXI_61_31";
   attribute HU_SET of XLXI_62 : label is "XLXI_62_30";
   attribute HU_SET of XLXI_94 : label is "XLXI_94_28";
begin
   XLXI_1 : D4_16E_MXILINX_sch
      port map (A0=>XLXN_245,
                A1=>XLXN_246,
                A2=>XLXN_247,
                A3=>XLXN_248,
                E=>XLXN_260,
                D0=>CFG_N(0),
                D1=>CFG_N(1),
                D2=>CFG_N(2),
                D3=>CFG_N(3),
                D4=>CFG_N(4),
                D5=>CFG_N(5),
                D6=>CFG_N(6),
                D7=>CFG_N(7),
                D8=>CFG_N(8),
                D9=>CFG_N(9),
                D10=>CFG_N(10),
                D11=>CFG_N(11),
                D12=>CFG_N(12),
                D13=>CFG_N(13),
                D14=>CFG_N(14),
                D15=>CFG_N(15));
   
   XLXI_12 : CB16X1_MXILINX_sch
      port map (C=>XLXN_226,
                CED=>XLXN_171,
                CEU=>XLXN_168,
                CLR=>XLXN_168,
                D(15 downto 0)=>CFG_N(15 downto 0),
                L=>dds_timer_OL,
                CEOD=>open,
                CEOU=>open,
                Q=>open,
                TCD=>dds_timer_OL,
                TCU=>open);
   
   XLXI_19 : INV
      port map (I=>XLXN_110,
                O=>DAC_LDAC);
   
   XLXI_21 : AND2
      port map (I0=>XLXN_111,
                I1=>Output_enable,
                O=>XLXN_110);
   
   XLXI_55 : VCC
      port map (P=>XLXN_171);
   
   XLXI_56 : GND
      port map (G=>XLXN_168);
   
   XLXI_57 : INV
      port map (I=>CFG_N(0),
                O=>Output_enable);
   
   XLXI_61 : D2_4E_MXILINX_sch
      port map (A0=>XLXN_175,
                A1=>XLXN_176,
                E=>XLXN_222,
                D0=>Delay_0_to_100ns,
                D1=>Delay_plus_100ns,
                D2=>XLXN_203,
                D3=>XLXN_204);
   
   XLXI_62 : CB2CE_MXILINX_sch
      port map (C=>XLXN_228,
                CE=>XLXN_239,
                CLR=>XLXN_243,
                CEO=>open,
                Q0=>XLXN_175,
                Q1=>XLXN_176,
                TC=>Block_timer_after_overload_until_new_cycle);
   
   XLXI_63 : OR2
      port map (I0=>Delay_plus_100ns,
                I1=>Delay_0_to_100ns,
                O=>Hold_LDAC_100ns_to_200ns);
   
   XLXI_72 : OR2
      port map (I0=>XLXN_204,
                I1=>XLXN_203,
                O=>Hold_IRQ_after_LDAC);
   
   XLXI_75 : VCC
      port map (P=>XLXN_222);
   
   XLXI_82 : AND2
      port map (I0=>Hold_LDAC_100ns_to_200ns,
                I1=>dds_timer_OL,
                O=>XLXN_111);
   
   XLXI_85 : BUFG
      port map (I=>DDS_FREQ,
                O=>XLXN_226);
   
   XLXI_86 : BUFG
      port map (I=>IN_10MHz,
                O=>XLXN_228);
   
   XLXI_87 : INV
      port map (I=>Block_timer_after_overload_until_new_cycle,
                O=>XLXN_239);
   
   XLXI_91 : INV
      port map (I=>dds_timer_OL,
                O=>XLXN_243);
   
   XLXI_92 : INV
      port map (I=>Block_timer_after_overload_until_new_cycle,
                O=>Block_IRQ_afrer_timeout);
   
   XLXI_93 : AND3
      port map (I0=>Block_IRQ_afrer_timeout,
                I1=>Hold_IRQ_after_LDAC,
                I2=>Output_enable,
                O=>CPU_IRQ);
   
   XLXI_94 : LD4_MXILINX_sch
      port map (D0=>Freq_control(0),
                D1=>Freq_control(1),
                D2=>Freq_control(2),
                D3=>Freq_control(3),
                G=>COUNT_EN,
                Q0=>XLXN_245,
                Q1=>XLXN_246,
                Q2=>XLXN_247,
                Q3=>XLXN_248);
   
   XLXI_97 : VCC
      port map (P=>XLXN_260);
   
end BEHAVIORAL;
