shodanx/Micron-GLIN-v.2/(commit log)

2022-04-26 Add SLS parts and Timebase module
    [4layer_main_board.PcbDoc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]
2022-04-26 Add DAC board
    [4layer_main_board.PcbDoc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]
2022-04-26 Add internal power board
    [Miscellaneous Devices.PcbLib, PCB1.PcbDoc, PCB1.PcbLib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]
2022-04-26 Add ouptut module
    [4layer_main_board.PcbDoc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]
2022-04-26 Fix +-30V trace
    [PCB1.PcbDoc, Ramp-generator.PrjPcb]
2022-04-26 Trace fix
    [PCB1.PcbDoc, Ramp-generator.PrjPcb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]
2022-05-01 Add External power PCB
    [EXT_power.PrjPcb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]
2022-05-01 Replace neon bulb to led. Fix IEC320 connector
    [PCB1.PcbDoc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]
2022-05-01 Add Rs for shunt caps for future use.
    [EXT_power.PrjPcb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]
2022-05-03 Add motherboardconnection matrix
    [Motherboard_connections.xlsx]
2022-05-03 Add digital board (incomplete)
    [4layer_main_board.PcbDoc, Miscellaneous Devices.PcbLib, Motherboard_connections.xlsx, PCB1.PcbLib, Ramp-generator.PrjPcb, Ramp-generator.SCHLIB, SamacSys.PcbLib, v2.SchDoc]
2022-05-03 optimize MCU pinout
    [4layer_main_board.PcbDoc, v2.SchDoc]
2022-05-03 Digital board in progress...
    [4layer_main_board.PcbDoc, v2.SchDoc]
2022-05-03 Digital board pre-release
    [4layer_main_board.PcbDoc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]
2022-05-04 small fixes
    [Ramp-generator.PrjPcb, v2.SchDoc]
2022-05-04 Add front panel
    [PCB1.PcbDoc, Power.SchDoc, Ramp-generator.PrjPcb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]
2022-05-06 Add motherboard
    [4layer_main_board.PcbDoc, Miscellaneous Devices.PcbLib, Motherboard_connections.xlsx, PCB1.PcbLib, Ramp-generator.PrjPcb, Ramp-generator.SCHLIB, SamacSys.PcbLib, v2.SchDoc]
2022-05-06 Fix motherboard
    [4layer_main_board.PcbDoc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]
2022-05-06 Fix TMP117 layout
    [4layer_main_board.PcbDoc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]
2022-05-06 projectfile fix
    [Ramp-generator.PrjPcb]
2022-05-07 Add assembly view
    [4layer_main_board.PcbDoc, Analogue.SchDoc, Ramp-generator.PrjPcb]
2022-05-09 Xilinx CPLD software added
    [a_0098054934_3212880686.nt64.obj, a_0147727936_3632337348.nt64.obj, a_0418817255_3212880686.nt64.obj, a_0897150575_3212880686.nt64.obj, a_1113154319_3729445679.nt64.obj, a_1391413833_1848422758.nt64.obj, a_1424174025_3212880686.nt64.obj, a_1490675510_1976025627.nt64.obj]
2022-05-10 Optimize CPLD
    [a_2451983098_3212880686.nt64.obj, a_3463945714_3212880686.nt64.obj, a_3888606632_3212880686.nt64.obj, sch.sch, sch_isim_beh.exe_main.nt64.obj, sch_pad.csv]
2022-05-11 add power placment
    [Ramp-generator.PrjPcb, sch_pad.csv]
2022-05-13 Fix external power source bugs and sch
    [EXT_power.PrjPcb, PCB1.PcbDoc, Sheet1.SchDoc]
2022-05-13 fix gerbers
    [EXT_power.PrjPcb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]
2022-05-14 Add capacitors to ferrite beads (fix LM3*9 unstable)
    [EXT_power.PrjPcb, PCB1.PcbDoc, Power.SchDoc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]
2022-05-15 Fix LM3*9 unstable
    [PCB1.PcbDoc, Power.SchDoc, Ramp-generator.PrjPcb]
2022-05-15 Fix LM3x9 instabillity.
    [PCB1.PcbDoc, Power.SchDoc]
2022-05-17 Internal_power_board - caps replaced to tantalum
    [PCB1.PcbDoc, Power.SchDoc, Ramp-generator.PrjPcb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]
2022-05-17 Change motherboard caps to tant.
    [4layer_main_board.PcbDoc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]
2022-05-18 Fix BOM
    [4layer_main_board.PcbDoc, PCB1.PcbDoc, Power.SchDoc, Ramp-generator.PrjPcb, v2.SchDoc]
2022-05-18 Change PMLL4148 diodes to high rate EGL1D
    [PCB1.PcbDoc, Power.SchDoc]
2022-05-18 Add stencil
    [4layer_main_board.PcbDoc, Ramp-generator.PrjPcb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]
2022-05-30 fix cap
    [PCB1.PcbDoc, Power.SchDoc, Ramp-generator.PrjPcb]
2022-06-13 Fix LTC2057 piout Fix zenners Add digital board assembly
    [4layer_main_board.PcbDoc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]
2022-06-22 Add Assembly Rename files
    [4layer_main_board.PcbDoc, Analogue.SchDoc, DAC_board.PrjPcb, DAC_board_PCB.PcbDoc, DAC_board_schematic.SchDoc, Digital board.PrjPcb, Digital_board_PCB.PcbDoc, Digital_board_schematic.SchDoc]
2022-06-22 Move assembly
    [DAC_board_PCB.PcbDoc]
2022-06-22 Organize files
    [Aluminium Front Panel.PcbDoc, Aluminium Front Panel.PrjPcb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]
2022-06-22 Fix projects
    [Aluminium Front Panel.PrjPcb, Internal Power board.PrjPcb, Output board.PrjPcb]
2022-06-23 Change title
    [Aluminium Front Panel_Copper_Signal_Bot.gbr, Aluminium Front Panel_Copper_Signal_Top.gbr, Aluminium Front Panel_Keep-out.gbr, Aluminium Front Panel_Legend_Bot.gbr, Aluminium Front Panel_Legend_Top.gbr, Aluminium Front Panel_Paste_Bot.gbr, Aluminium Front Panel_Paste_Top.gbr, Aluminium Front Panel_Profile.gbr]
2022-07-07 Add new trans ОСМ Т 230/Э/60-30/40-20/7-0.025-50
    [main_transformer V3.SchDoc, Рассчет тепловыделения.xlsx]
2022-07-08 fix consumption
    [ldo_calc.xlsx, Рассчет тепловыделения.xlsx]
2022-07-11 V2 MCU firmware Alfa release
    [Рассчет тепловыделения.xlsx]
2022-07-19 Add LEA-M8F module
    [Timebase board.PrjPcb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]
2022-07-21 Add GNSS antenna
    [AntennaPCB.GBL, AntennaPCB.GBO, AntennaPCB.GBP, AntennaPCB.GBS, AntennaPCB.GKO, AntennaPCB.GTL, AntennaPCB.GTO, AntennaPCB.GTP]
2022-07-23 Fix antenna circuit (imedance, lenght) Add antenna case
    [AntennaPCB.GBL, AntennaPCB.GBO, AntennaPCB.GBP, AntennaPCB.GBS, AntennaPCB.GKO, AntennaPCB.GTL, AntennaPCB.GTO, AntennaPCB.GTP]
2022-07-24 Update 3D models
    [Aluminium Front Panel.PcbDoc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]
2022-07-24 Update case
    [bot.SLDPRT, buttom_part.SLDPRT, top.SLDPRT, Сборка1.SLDASM]
2022-07-24 Fixed dimmensions
    [bot.SLDPRT, top.SLDPRT, Сборка1.SLDASM]
